mpresso/Hardware/PCB/EDU-NXP/Doc/CIAA_KIDS_Pinouts_Rev_0.0.xlsx

Sheet: CIAA_XXXX
CIAA_xxxx
CIAA_xxxx |  |  | LPC4337
On-board | I/O Expansion | expansion | Pin # | ALT0 | ALT1 | ALT2 | ALT3 | ALT4
 | P1 | TEC_F0 | 1 | DIN0
 | P1 | Entrada Analog. 0 | 2 | ADCO_1 | ADC1_1
 | P1 | TEC_F1 | 3 | DIN1
 |  |  | 4 | VSSIO
 |  |  | 5 | VDDIO
 | P1 | Salida Analog. | 6 | DAC | ADC0_0 | ADC1_0
 | P1 | TEC_F3 | 7 | DIN3
 | P1 | TEC_F2 | 8 | DIN2
 | P1 | LCD1 | 9 | DOUT
 | P1 | LCD2 | 10 | DOUT
 | P1 | LCD3 | 11 | DOUT
XTAL1 |  |  | 12 | XTAL1
XTAL2 |  |  | 13 | XTAL2
 |  |  | 14 | P4_7
 | P1 | LCD_RS | 15 | DOUT
 |  |  | 16 | USB0_VDDA_3V3_DRIVER
 |  |  | 17 | USB0_VDDA3V3
USB0 |  | USB_DP | 18 | USB0_DP
 |  |  | 19 | USB0_VSSA_TERM
USB0 |  | USB_DM | 20 | USB0_DM
USB0 |  | USB_VBUS | 21 | USB0VBUS
USB0 |  | USB_ID | 22 | USB0_ID
 |  |  | 23 | USB0_VSSA_REF
 |  |  | 24 | USB0_RREF
 |  |  | 25 | VDDREG
 |  |  | 26 | TDI
 |  |  | 27 | TCK | SWDCLK
 |  |  | 28 | DBGEN
 |  |  | 29 | nTRST
 |  |  | 30 | TMS | SWDIO
 |  |  | 31 | TDO | SWO
 | P2 | Ethernet_RXD1 | 32 | P0_0
 | P1 | LCD_EN | 33 | DOUT
 | P2 | Ether_TX_EN | 34 | P0_1
 | P1 | LCD | 35 | DOUT
 |  |  | 36 | VDDIO
 |  |  | 37 | P5_0
PULS_0 |  | DIN | 38 | P1_0
 |  |  | 39 | P5_1
VSSIO |  |  | 40 | VSSIO
VDDIO |  |  | 41 | VDDIO
PULS_1 |  | DIN | 42 | P1_1
PULS_2 |  | DIN | 43 | P1_2
 | P2 | SPI_MISO | 44 | P1_3
 |  |  | 45
 |  |  | 46 | P5_2
 | P2 | SPI_MOSI | 47 | P1_4
 | P1 | TEC_COL0 | 48 | DIN
PULS_3 |  | DIN | 49 | P1_6
 |  |  | 50 | P1_7
 |  |  | 51 | P1_8
 |  |  | 52 | P1_9
 |  |  | 53 | P1_10
 |  |  | 54 | P5_3
 |  |  | 55 | P1_11
 |  |  | 56 | P1_12
 |  |  | 57 | P5_4
 |  |  | 58 | P5_5
VDDREG |  |  | 59 | VDDREG
 |  |  | 60 | P1_13
 |  |  | 61 | P1_14
 | P2 | Ethernet_rxdo | 62 | P1_15
 |  |  | 63 | P5_6
 | P2 | Ethernet_CRS_DV | 64 | P1_16
 |  |  | 65 | P5_7
 | P2 | Ethernet_MDIO | 66 | P1_17
 | P2 | Ethernet_TXDO | 67 | P1_18
 | P2 | Ethernet_REF_CLK | 68 | P1_19
RS485 |  | RS485_TXD | 69 | P9_5
 | P2 | Ethernet_TXD1 | 70 | P1_20
VDDIO |  |  | 71 | VDDIO
RS485 |  | RS485_RXD | 72 | P9_6
 |  |  | 73 | P6_0
 | P1 | GPIO0 | 74 | P6_1
led0_r |  | DOUT | 75 | P2_0
VSSIO |  |  | 76 | VSSIO
VDDIO |  |  | 77 | VDDIO
RS485 |  | RS485_DIR | 78 | P6_2
USB0 |  | USB_PPWR | 79 | P6_3
 |  |  | 80 | P6_4
ledo_g |  | DOUT | 81 | P2_1
 |  |  | 82 | P6_5
USB0 |  | USB_PWR_FAULT | 83 | P6_6
led0_b |  | DOUT | 84 | P2_2
 |  |  | 85 | P6_7 | GPIO03 | RS232_CTS | SPI_CS
 |  |  | 86 | P6_8
 | P2 | RS232_TXD | 87 | P2_3 | RS232_TXD
 | P2 | RS232_RXD | 88 | P2_4 | RS232_RXD
USB1 |  | USB_DP | 89 | USB1_DP
USB1 |  | USB_DM | 90 | USB1_DM
 | P1 | GPIO3 | 91 | P2_5 | GPIO1 | CAN_STB
 | P2 | I2C | 92 | I2C0_SCL
 | P2 | I2C | 93 | I2C0_SDA
VDDREG |  |  | 94 | VDDREG
 | P1 | GPIO1 | 95 | P2_6
 |  |  | 96 | P2_7
 |  |  | 97 | P6_9
led1_r |  | DOUT | 98 | P2_8
 |  |  | 99
led2_r |  | DOUT | 100 | P6_10
led2_g |  | DOUT | 101 | P6_11
led1_g |  | DOUT | 102 | P2_9
led2_b |  | DOUT | 103 | P6_12
led1_b |  | DOUT | 104 | P2_10
led3_r |  | DOUT | 105 | P2_11
led3_g |  | DOUT | 106 | P2_12
 |  |  | 107 | VDDIO
led3_b |  | DOUT | 108 | P2_13
VSSIO |  |  | 109 | VSSIO
 | P1 | GPIO4 | 110 | P7_0 | GPIO2 | RS232_RTS
VDDIO |  |  | 111 | VDDIO
 |  |  | 112 | P3_0
 |  |  | 113 | P7_1
 | P2 | CAN_RD | 114 | P3_1
 |  |  | 115 | P7_2
 | P2 | CAN_TD | 116 | P3_2
 |  |  | 117 | P7_3
 |  |  | 118 | P3_3
 |  |  | 119 | P3_4
 | P2 | SPI_SCK | 120 | PF_4
 |  |  | 121 | P3_5
 |  |  | 122 | P3_6
 |  |  | 123 | P3_7
 |  |  | 124 | P3_8
RTCX1 |  |  | 125 | RTCX1
RTCX2 |  |  | 126 | RTCX2
 |  |  | 127 | VBAT
RESET | CON | RESET | 128 | nRESET
 | P2 | GPIO5 | 129 | RTC_ALARM | GPIO5 | RTC_ALARM
 | P2 | WAKEUP | 130 | WAKEUP0
 |  |  | 131 | VDDREG
 | P1 | TEC_COL1 | 132 | P7_4
 | P1 | TEC_COL2 | 133 | P7_5
 | P1 | ISP | 134
VSSA |  |  | 135 | VSSA
 | P2 | GPIO6 | 136 | GPIO | ADC0_7 | ADC1_7
VDDA |  |  | 137 | VDDA
 | COM0 | Entrada Analog. 3 | 138 | ADC0_4 | ADC1_4
 | P1 | Entrada Analog. 2 | 139 | ADC0_3 | ADC1_3
 | P2 | Ethernet_MDC | 140 | P7_7
VDDIO |  |  | 141 | VDDIO
 | P2 | GPIO7 | 142 | GPIO | ADC0_6 | ADC1_6
 | P1 | Entrada Analog. 1 | 143 | ADC0_2 | adc1_2
 | P2 | GPIO8 | 144 | GPIO | ADC0_5 | ADC1_5

Sheet: EXPANSION
COM0 |  |  |  | COM1
Pin | Señal | Pin | Señal | Pin | Señal | Pin | Señal
1 | TEC_F0 | 2 | ADC0_1 | 1 | ETH_MDC | 2 | SPI_SCK
3 | TEC_F1 | 4 | ADC0_2 | 3 | ETH_RXD1 | 4 | SPI_MISO
5 | TEC_F2 | 6 | GND | 5 | ETH_TX_EN | 6 | SPI_MOSI
7 | TEC_F3 | 8 | ADC0_3 | 7 | ETH_RXD0 | 8 | GND
9 | TEC_COL0 | 10 | ADC0_4 | 9 | RTH_CRS_DV | 10 | I2C_SCL
11 | TEC_COL1 | 12 | GND | 11 | ETH_MDIO | 12 | I2C_SDA
13 | TEC_COL2 | 14 | GPIO0 | 13 | ETH_TCD0 | 14 | GND
15 | TEC_ISP | 16 | GPIO1 | 15 | ETH_REF_CLK | 16 | CAN_RD
17 | GND | 18 | GPIO2 | 17 | ETH_TXDI | 18 | CAN_TD
19 | RESET | 20 | GPIO3 | 19 | GND | 20 | GND
21 | WAKEUP | 22 | GPIO4 | 21 | GND | 22 | GPIO5
23 | GND | 24 | GND | 23 | RESET | 24 | GPIO6
25 | VDDIO | 26 | VDDA | 25 | VDDIO | 26 | VDDA
27 | VSSA | 28 |  | 27 | VSSA | 28
