mpresso/Hardware/PCB/EDU-NXP/docs/LPC4330_Xplorer_schematic.pdf

# Page 2

# Power,Flash,SDcard

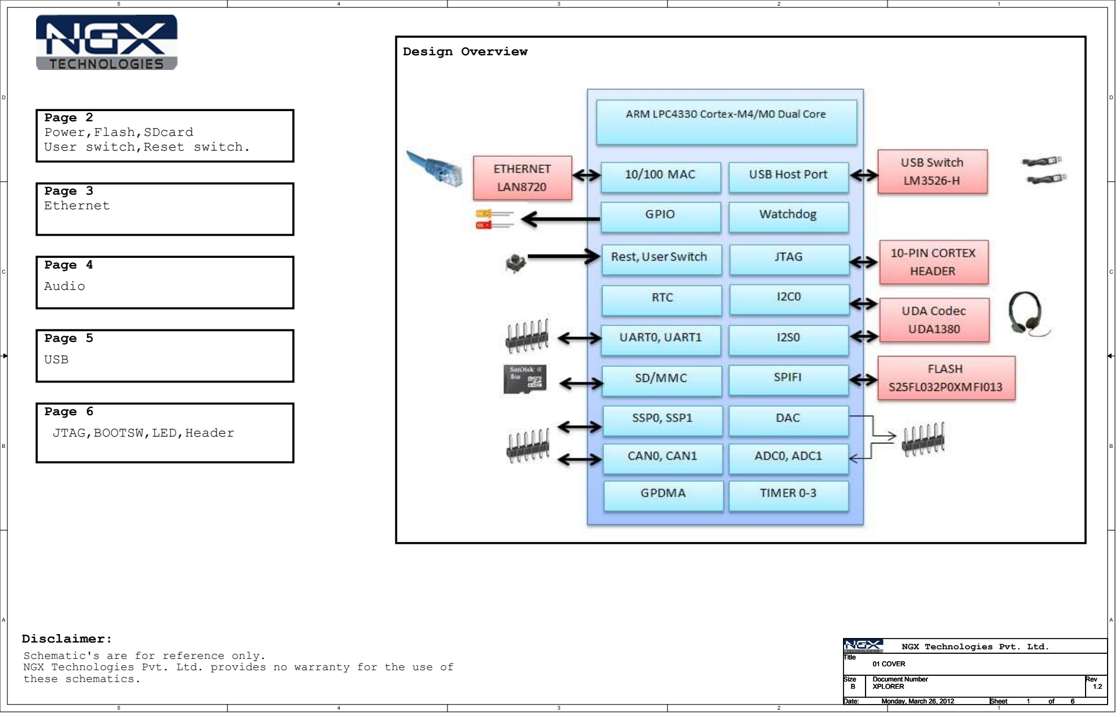
[picture p2: page 1]
Page 3; Page 4; Ethernet; Page 5; USB; Design Overview; Audio; Title; Size; Document Number; Rev; Date:; Sheet; XPLORER; 01 COVER; Monday, March 26, 2012

User switch,Reset switch.

Page 6
JTAG,BOOTSW,LED,Header

Disclaimer:
Schematic's are for reference only.
NGX Technologies Pvt. Ltd. provides no warranty for the use of
these schematics.

NGX Technologies Pvt. Ltd.

RESET SWITCH | USER SWITCH

# SD CARD

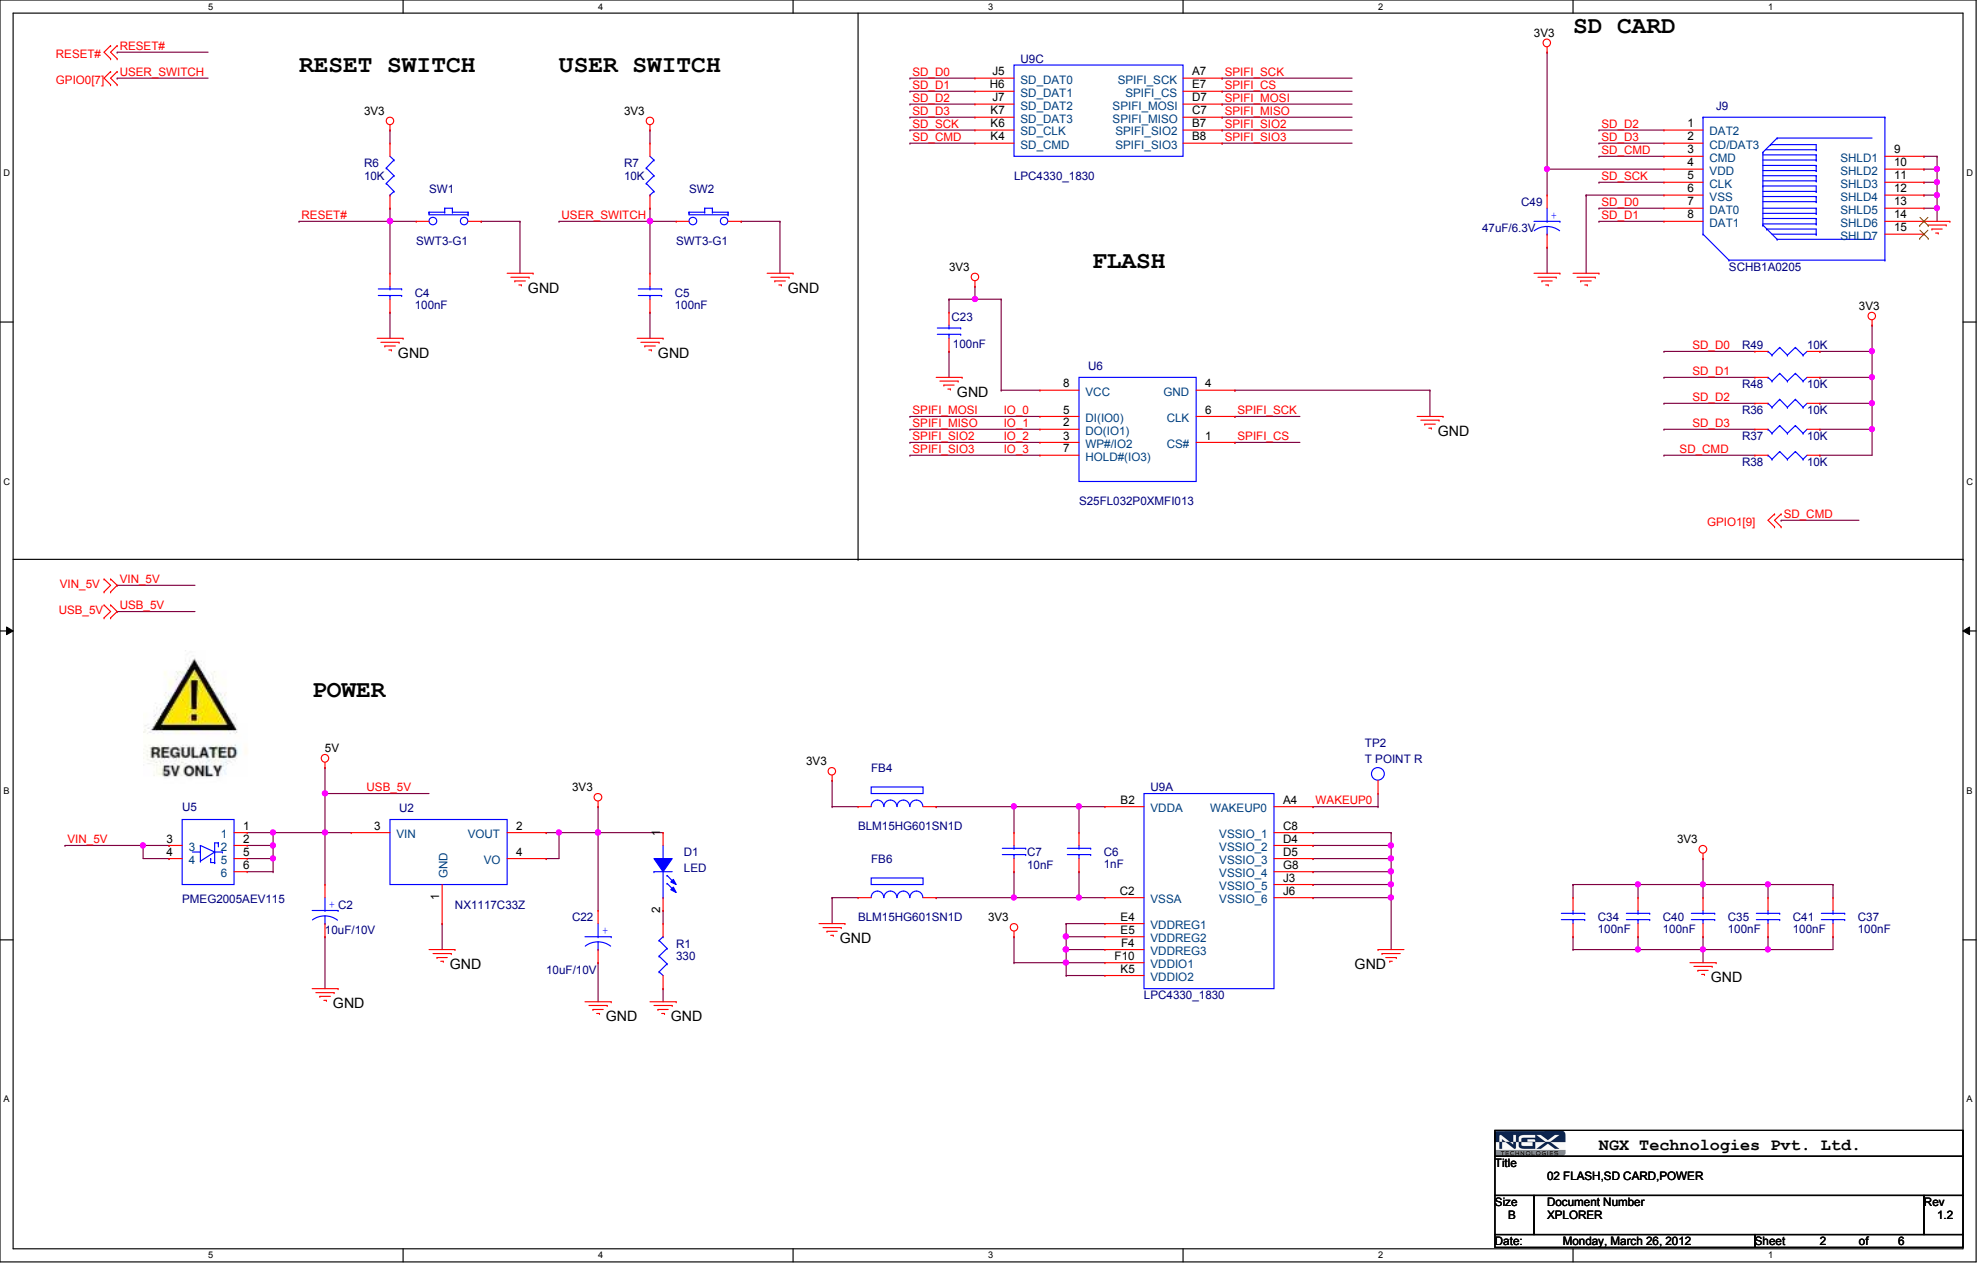
[picture p3: page 2]

NGX Technologies Pvt. Ltd.

02 FLASH,SD CARD,POWER

# ETHERNET

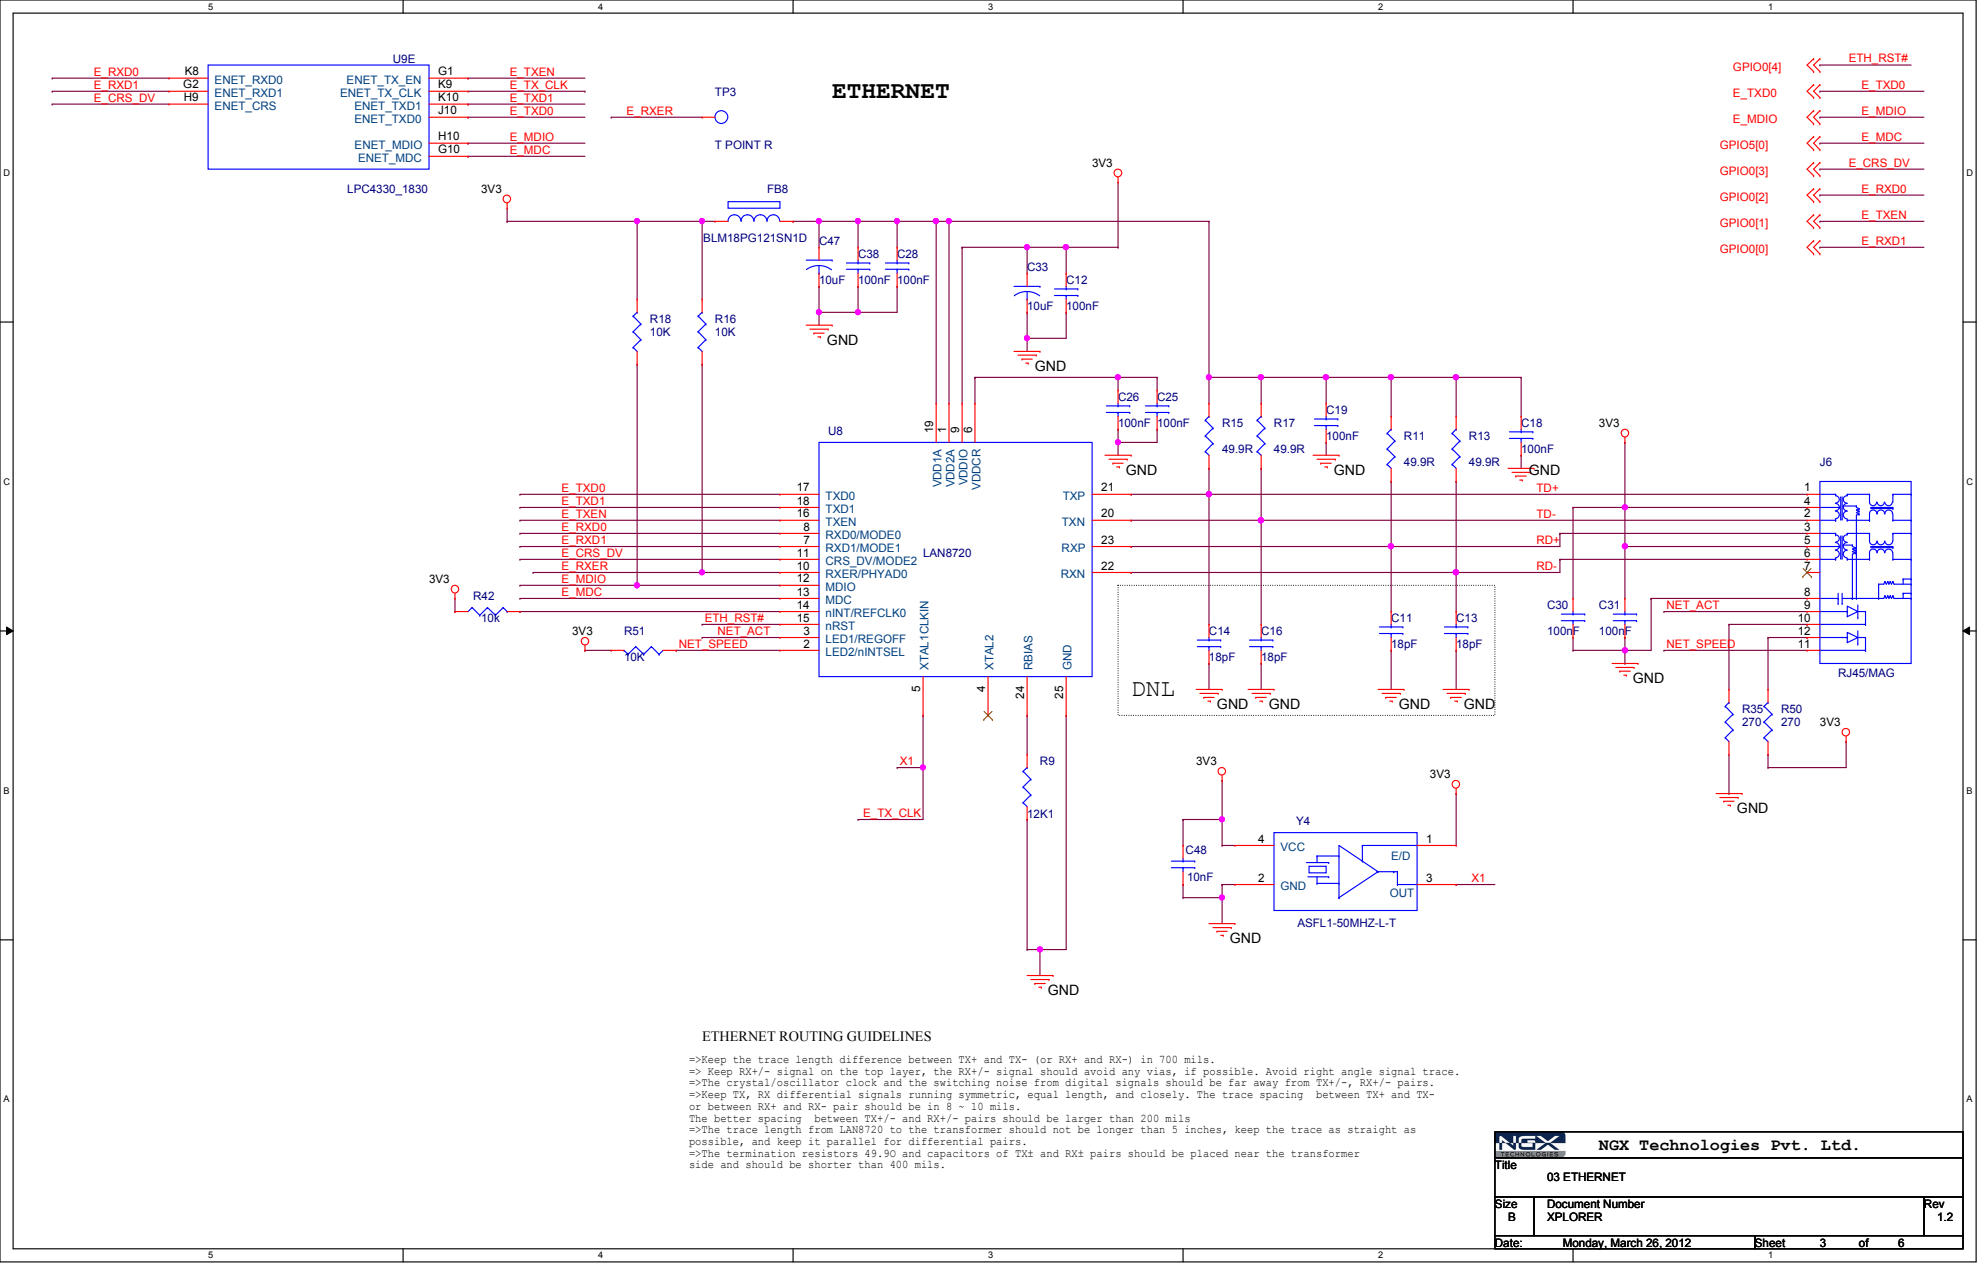
[picture p4: page 3]

=>Keep the trace length difference between TX+ and TX- (or RX+ and RX-) in 700 mils.
=> Keep RX+/- signal on the top layer, the RX+/- signal should avoid any vias, if possible. Avoid right angle signal trace.
=>The crystal/oscillator clock and the switching noise from digital signals should be far away from TX+/-, RX+/- pairs.
=>Keep TX, RX differential signals running symmetric, equal length, and closely. The trace spacing between TX+ and TX-
or between RX+ and RX- pair should be in 8 ~ 10 mils.
The better spacing between TX+/- and RX+/- pairs should be larger than 200 mils
=>The trace length from LAN8720 to the transformer should not be longer than 5 inches, keep the trace as straight as
possible, and keep it parallel for differential pairs.
=>The termination resistors 49.9O and capacitors of TX± and RX± pairs should be placed near the transformer
side and should be shorter than 400 mils.

NGX Technologies Pvt. Ltd.

# UDA CODEC

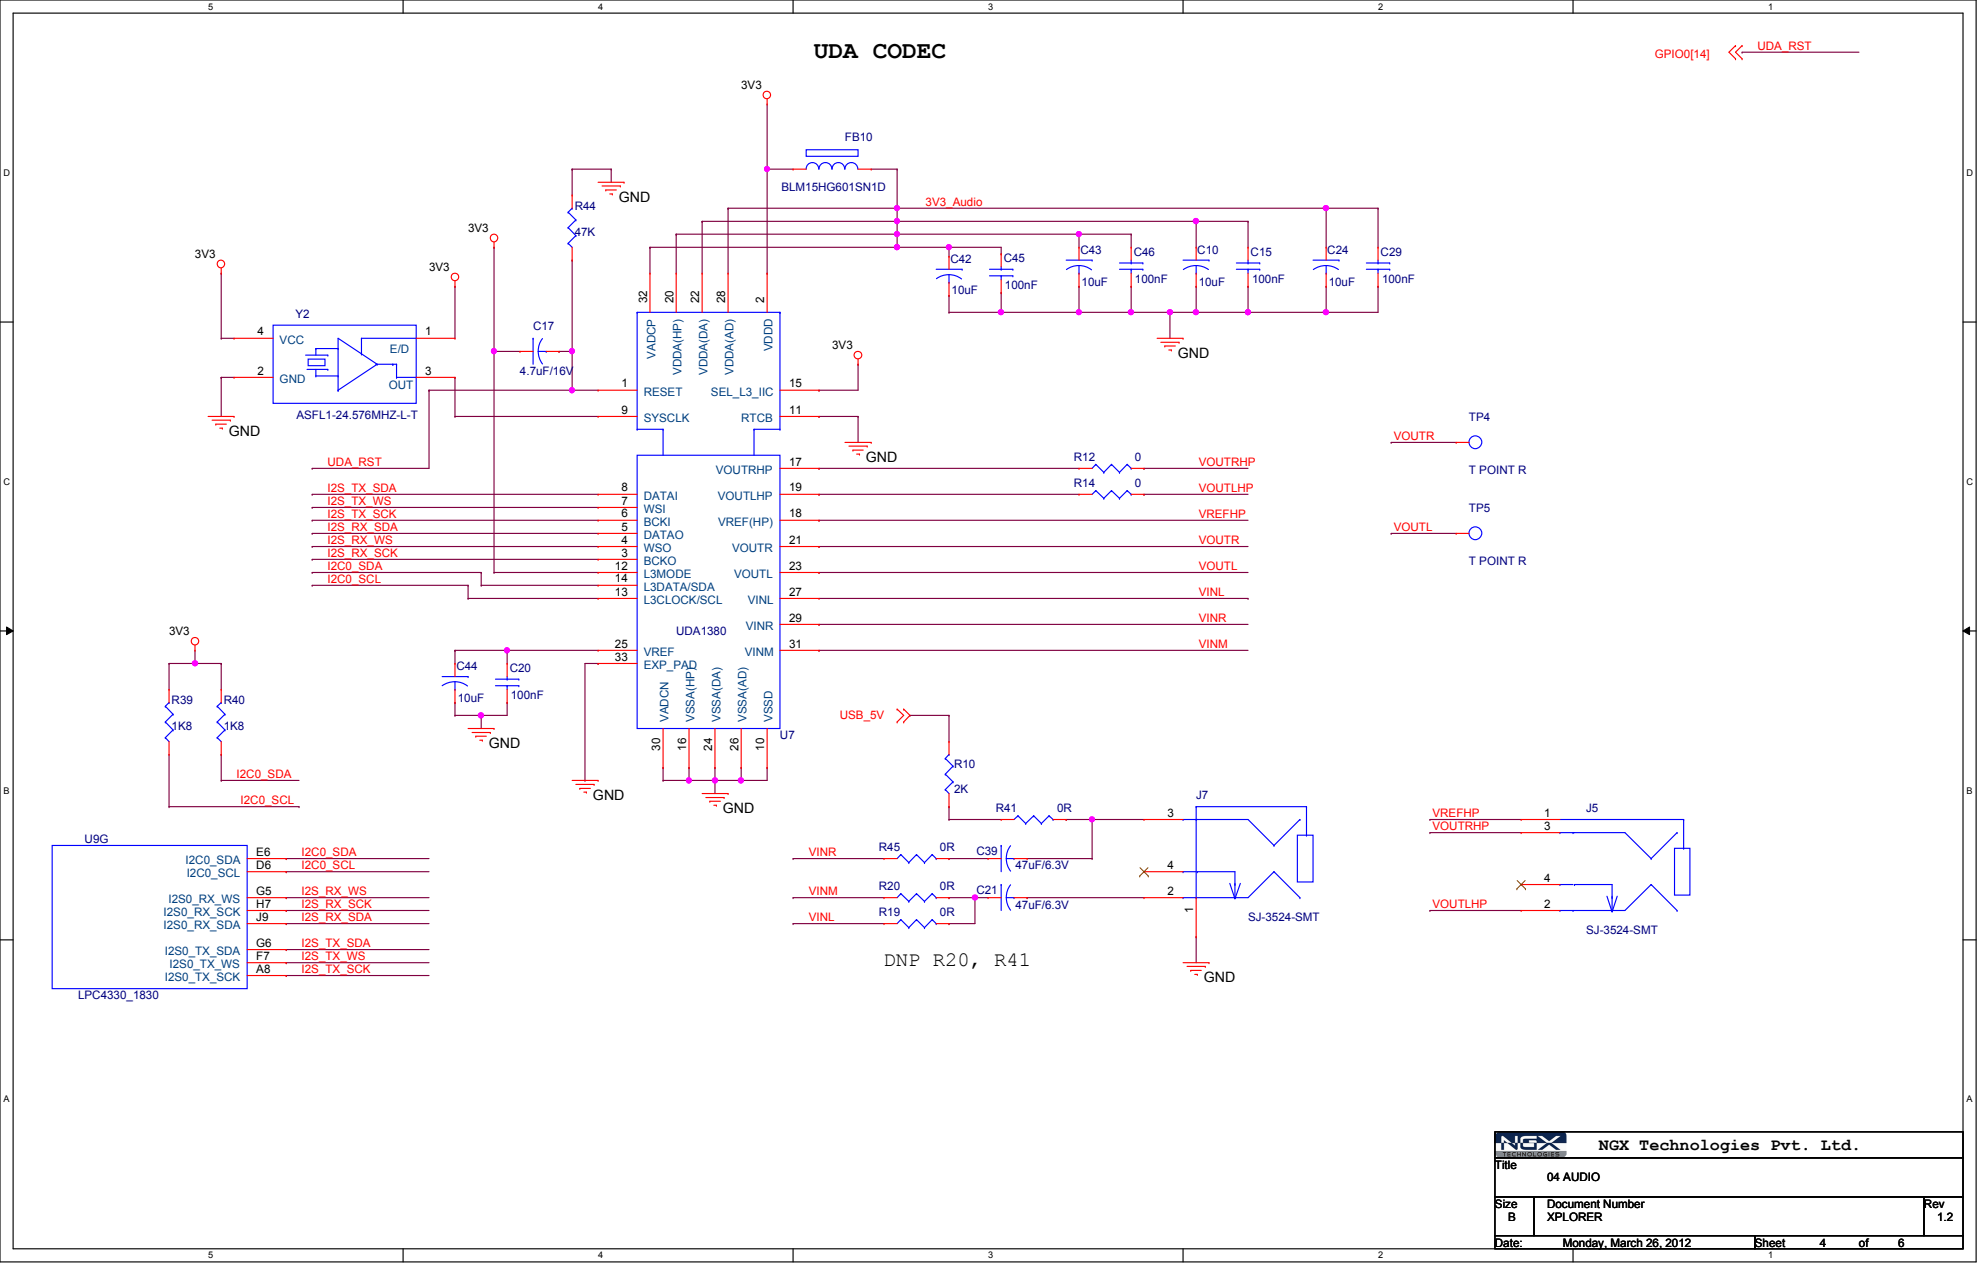
[picture p5: page 4]

NGX Technologies Pvt. Ltd.

# USB SECTION

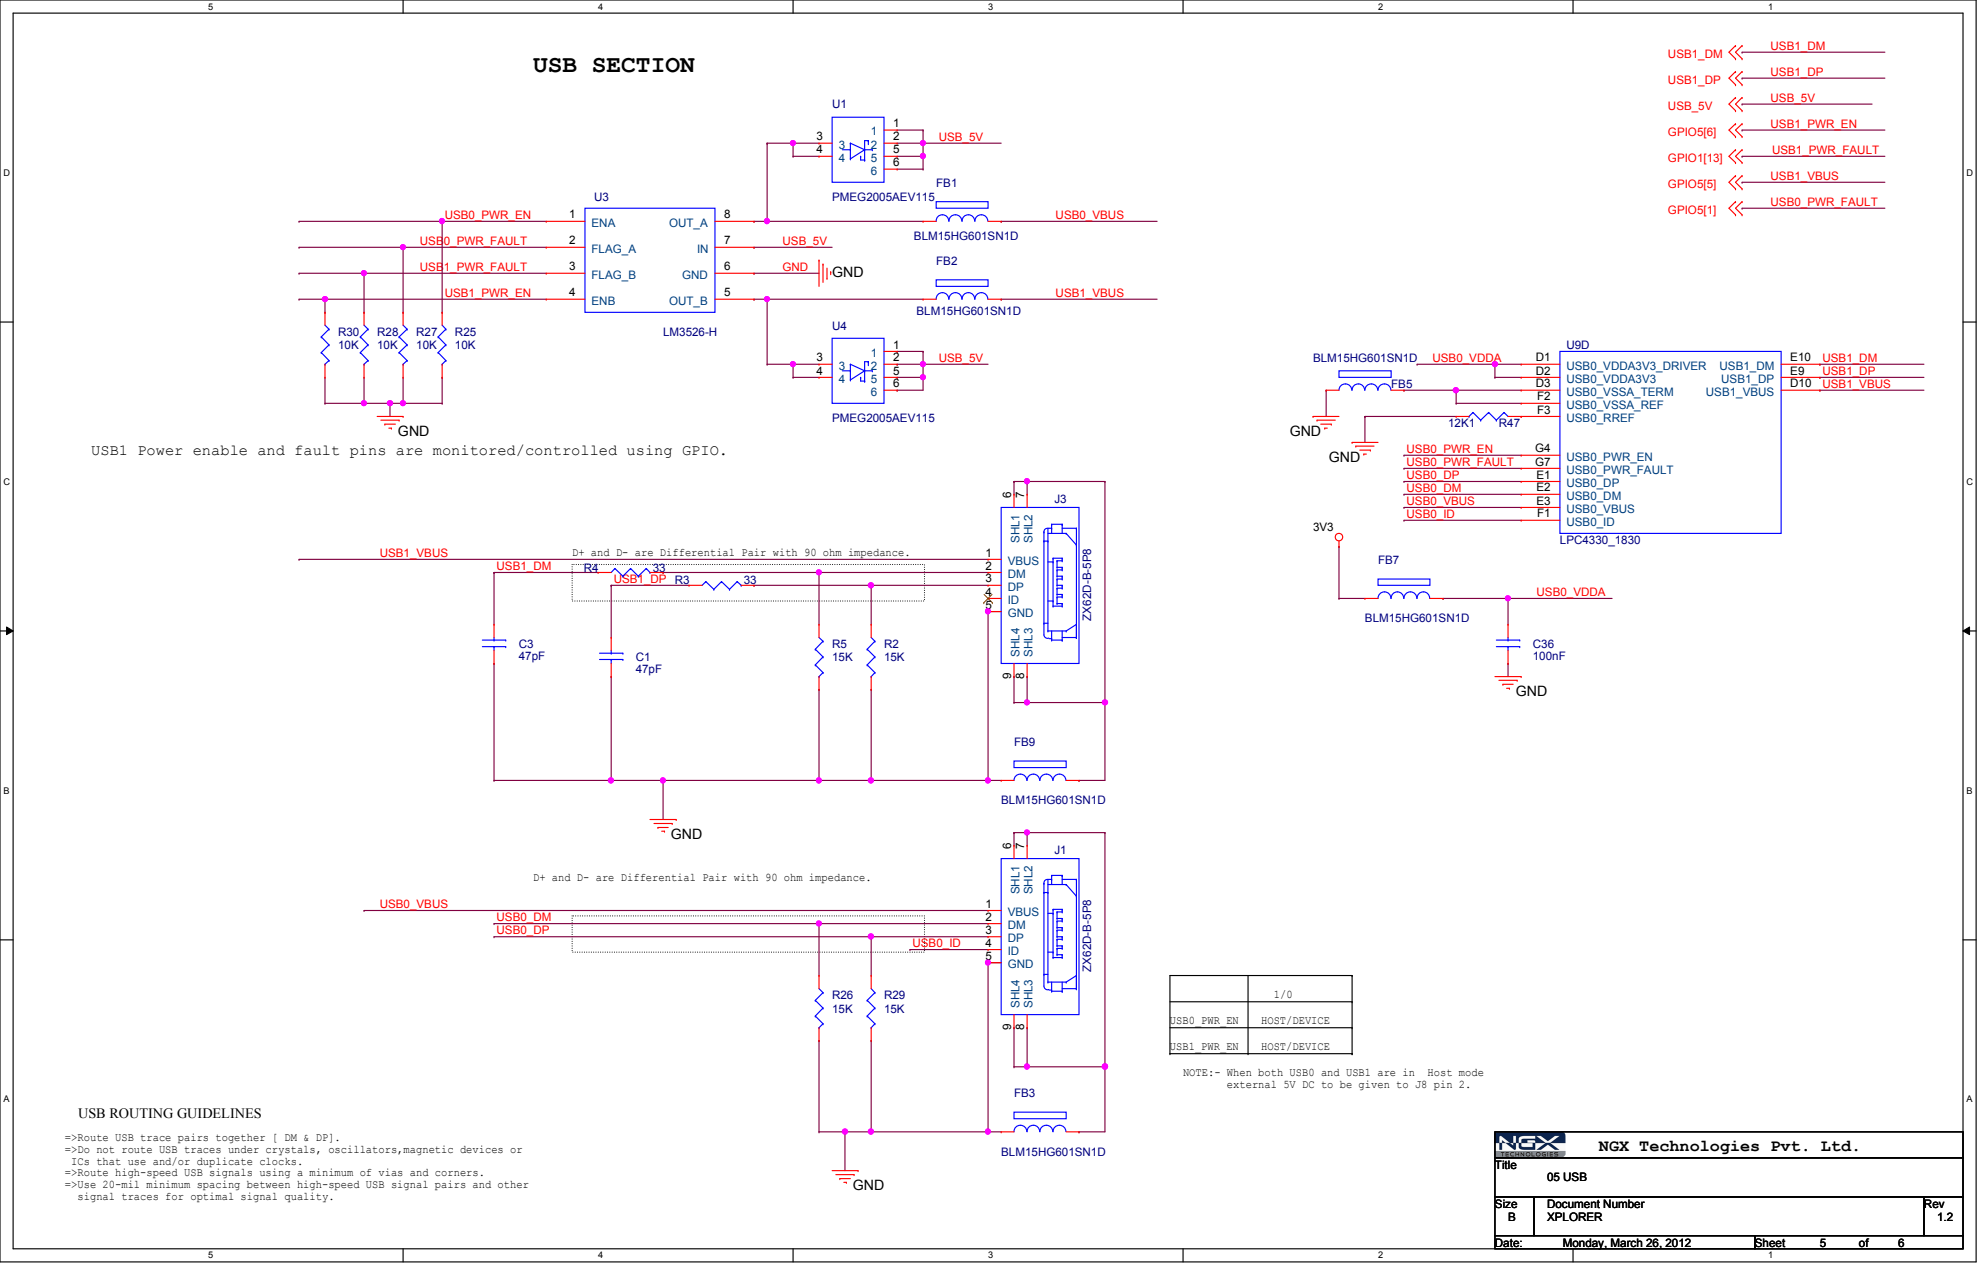
[picture p6: page 5]

USB1 Power enable and fault pins are monitored/controlled using GPIO.

D+ and D- are Differential Pair with 90 ohm impedance.
USB1_DP

ZX62D-B-5P8 VBUS 1 DM 2 DP 3 ID 4 GND 5

USB0_PWR_EN | HOST/DEVICE

USB1_PWR_EN | HOST/DEVICE

NOTE:- When both USB0 and USB1 are in Host mode

external 5V DC to be given to J8 pin 2.

=>Route USB trace pairs together [ DM & DP].
=>Do not route USB traces under crystals, oscillators,magnetic devices or
ICs that use and/or duplicate clocks.
=>Route high-speed USB signals using a minimum of vias and corners.
=>Use 20-mil minimum spacing between high-speed USB signal pairs and other
signal traces for optimal signal quality.

NGX Technologies Pvt. Ltd.

# BOOT SELECT SWITCH

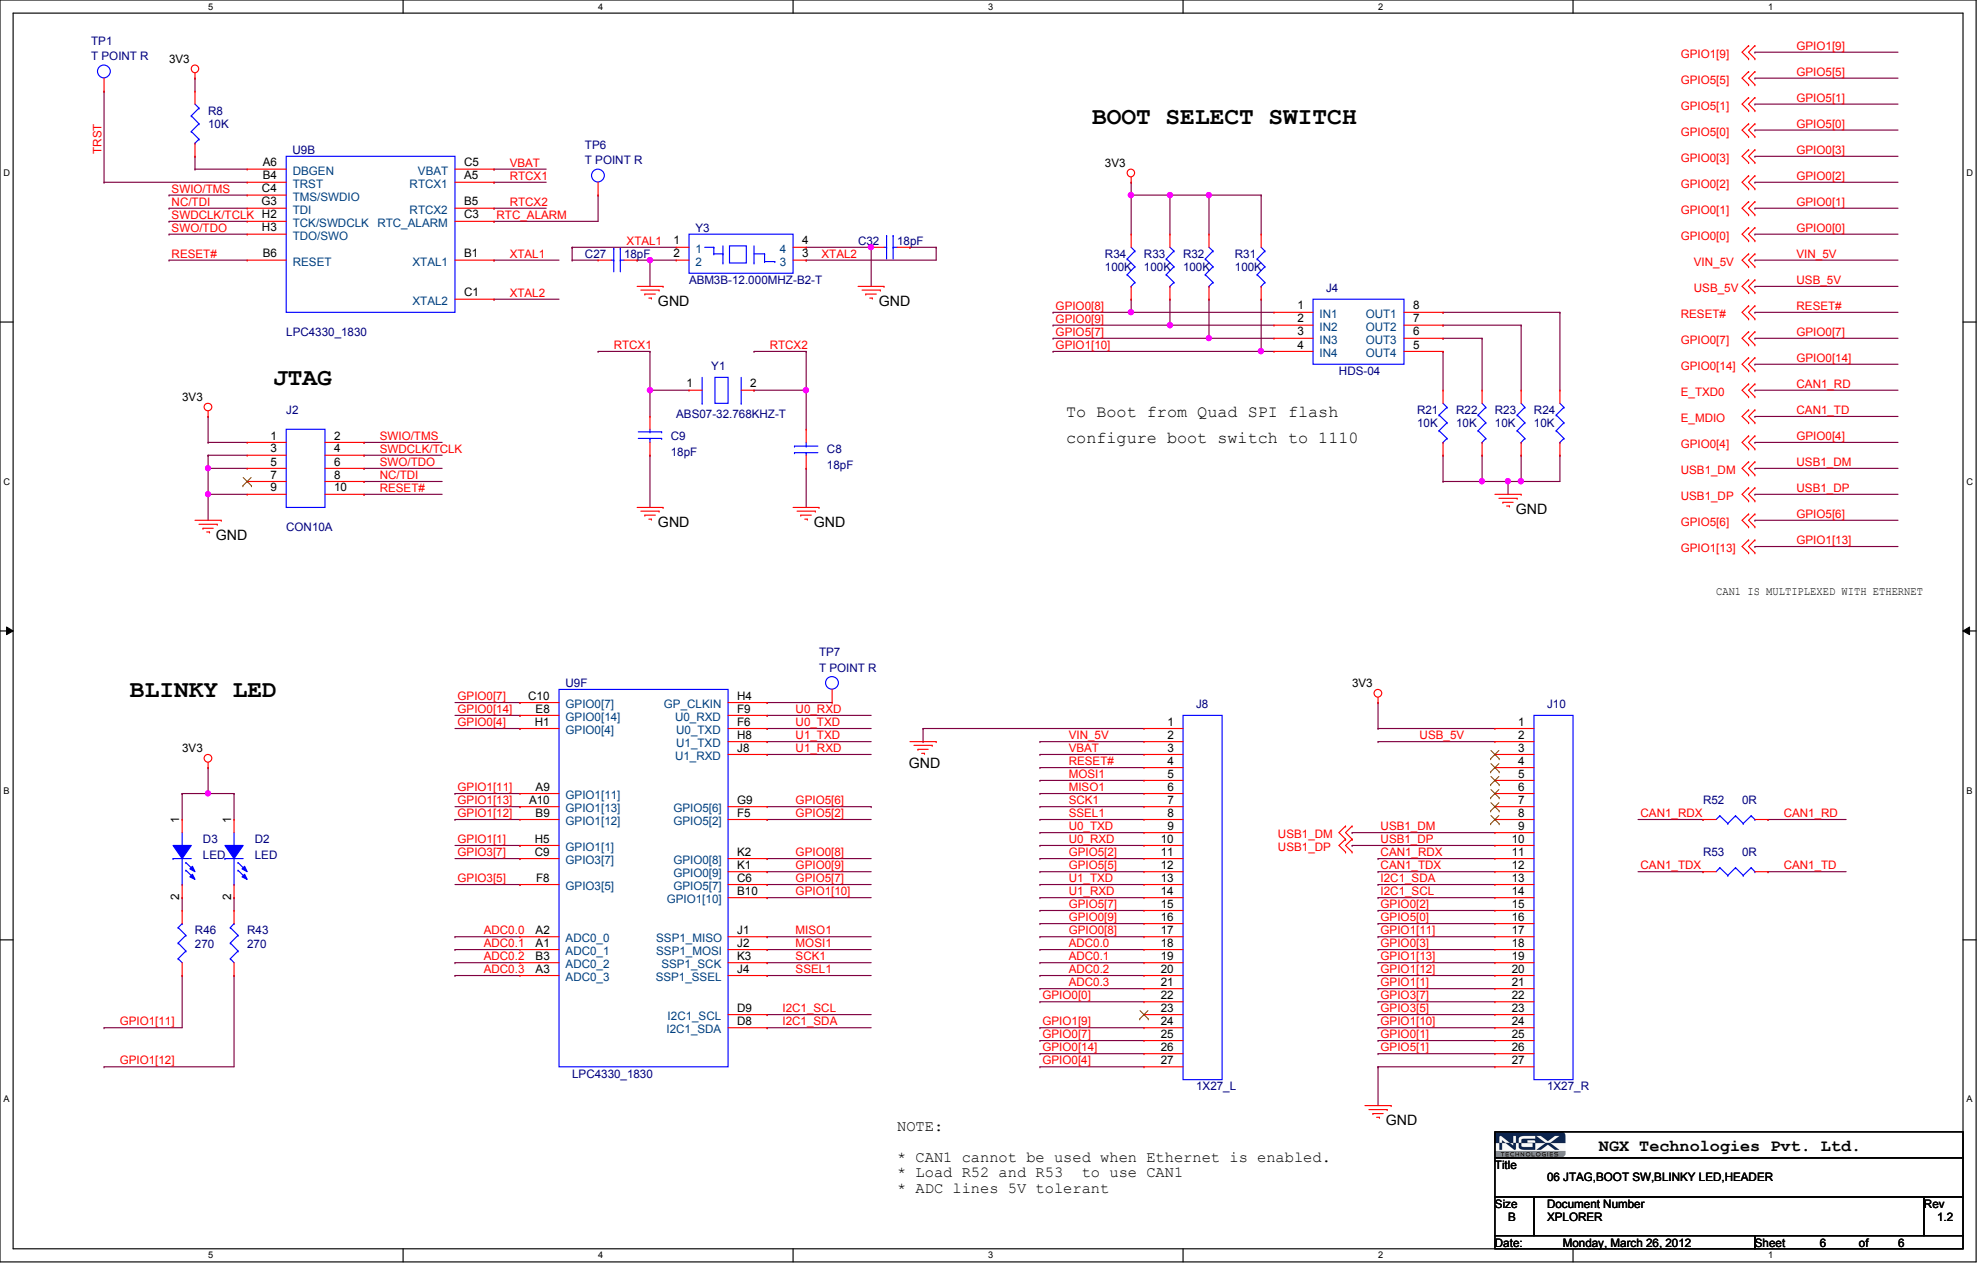
[picture p7: page 6]

To Boot from Quad SPI flash
configure boot switch to 1110

CAN1 IS MULTIPLEXED WITH ETHERNET

NGX Technologies Pvt. Ltd.

* CAN1 cannot be used when Ethernet is enabled.
* ADC lines 5V tolerant

06 JTAG,BOOT SW,BLINKY LED,HEADER
