mpresso/Hardware/PCB/EDU-NXP/edu-ciaa-nxp.kicad_pcb

## KiCad design PCB/EDU-NXP/edu-ciaa-nxp.kicad_pcb (2014-07-04)

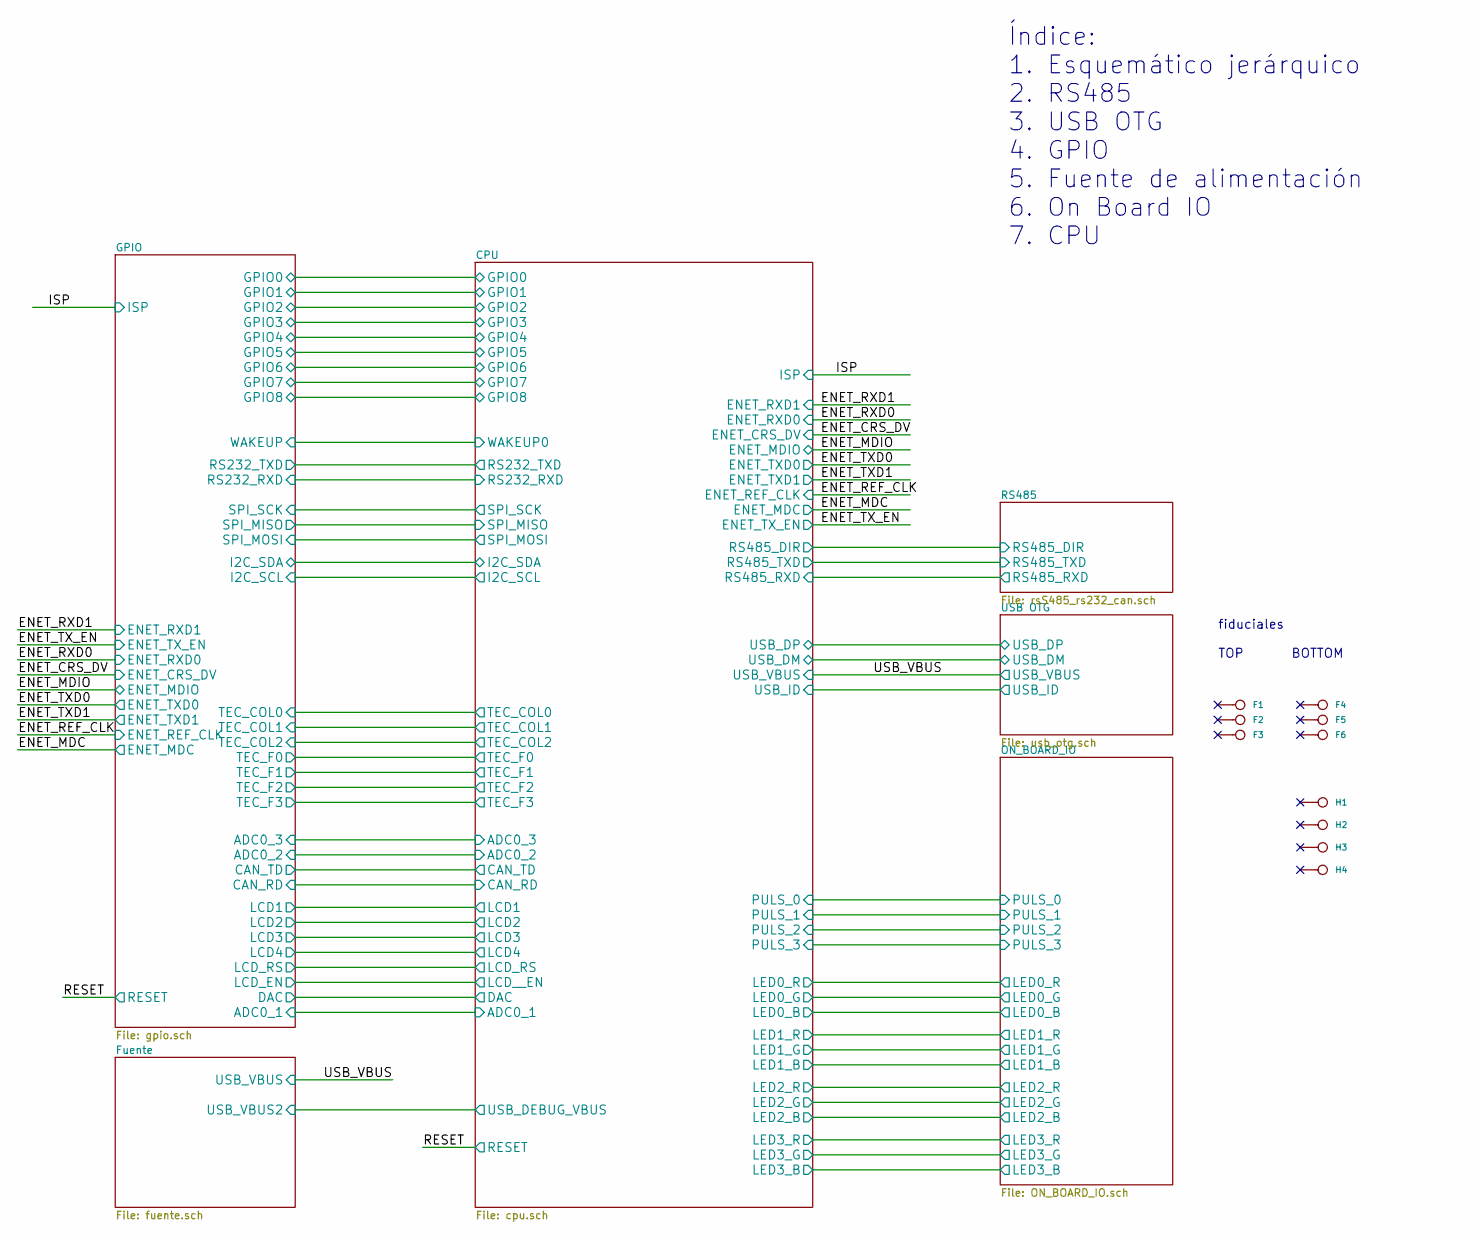
[picture p8: schematic edu-ciaa-nxp.sch, EDU CIAA NXP]

Parts:
F1, F2, F3, F4, F5, F6: fiducial
H1, H2, H3, H4: 4mm

Notes on the sheet:
Índice: 1. Esquemático jerárquico 2. RS485 3. USB OTG 4. GPIO 5. Fuente de alimentación 6. On Board IO 7. CPU
fiduciales TOP BOTTOM

Schematic: rsS485_rs232_can.sch, EDU CIAA RS485

Parts:
C1: 10uF / 6V3
C2: 100nF
D1, D2, D3: PSD12C
J1: TB_1X3
JP1, JP2, JP3, JP4: JUMPER-2
PS1, PS2: USMF020
R1, R2, R3: 4K7
R4, R5: 100K
R6, R8: 680
R7: 120
R9: 100 / 1/2W
U1: MAX3072; SOIC8

Connections:
+5V: C1.2, C2.1 (A), D1.1 (cathode), R4.1 (A), R6.1 (A), U1.8 (VCC); also elsewhere on the board
/CPU/RS485_DIR: JP1.1, R3.1 (A), U1.3 (DE); also elsewhere on the board
/CPU/RS485_RXD: R1.2 (B), U1.1 (RO); also elsewhere on the board
/CPU/RS485_TXD: U1.4 (DI); also elsewhere on the board
GND: C1.1 (GND), C2.2 (B), D3.2 (Anode), R2.2 (B), R3.2 (B), R5.2 (B), R8.2 (B), R9.1 (A), U1.5 (GND); also elsewhere on the board
unnamed 144: J1.2, PS2.2; also elsewhere on the board
unnamed 145: J1.3, R9.2 (B); also elsewhere on the board
unnamed 146: J1.1, PS1.2; also elsewhere on the board
unnamed: D1.2 (Anode), D2.1 (cathode), JP2.1, JP3.2, PS1.1, R4.2 (B), U1.6 (A)
unnamed: JP4.1, R8.1 (A)
unnamed: JP2.2, R6.2 (B)
unnamed: JP3.1, R7.1 (A)
unnamed: JP1.2, R2.1 (A), U1.2 (~RE~)
unnamed: D2.2 (Anode), D3.1 (cathode), JP4.2, PS2.1, R5.1 (A), R7.2 (B), U1.7 (B)

Notes on the sheet:
RS485
JP1, JP2, JP4: cortocircuitar en caso que sea el último nodo de la red.
De acuerdo a Fig 27 de la AN: slla070d de TI.

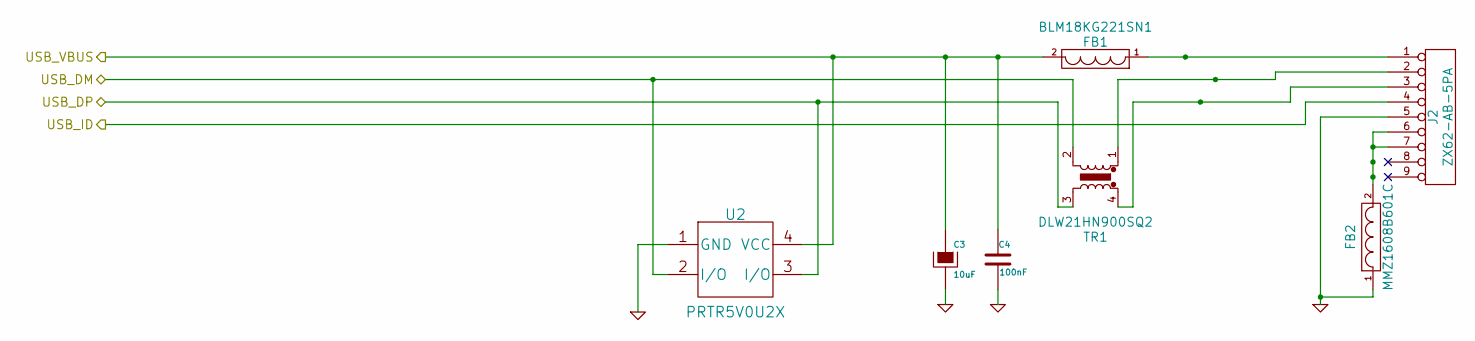
[picture p9: schematic usb_otg.sch, EDU CIAA USB OTG]

Parts:
C3: 10uF
C4: 100nF
FB1: BLM18KG221SN1
FB2: MMZ1608B601C
J2: ZX62-AB-5PA
TR1: DLW21HN900SQ2
U2: PRTR5V0U2X

Connections:
/CPU/USB_DM: TR1.2, U2.2 (I/O); also elsewhere on the board
/CPU/USB_DP: TR1.3, U2.3 (I/O); also elsewhere on the board
/CPU/USB_ID: J2.4; also elsewhere on the board
/CPU/USB_VBUS: C3.1, C4.1, FB1.2, U2.4 (VCC); also elsewhere on the board
GND: C3.2, C4.2, FB2.1, J2.5, U2.1 (GND); also elsewhere on the board
unnamed: FB2.2, J2.6, J2.7
unnamed: J2.3, TR1.4
unnamed: FB1.1, J2.1
unnamed: J2.2, TR1.1

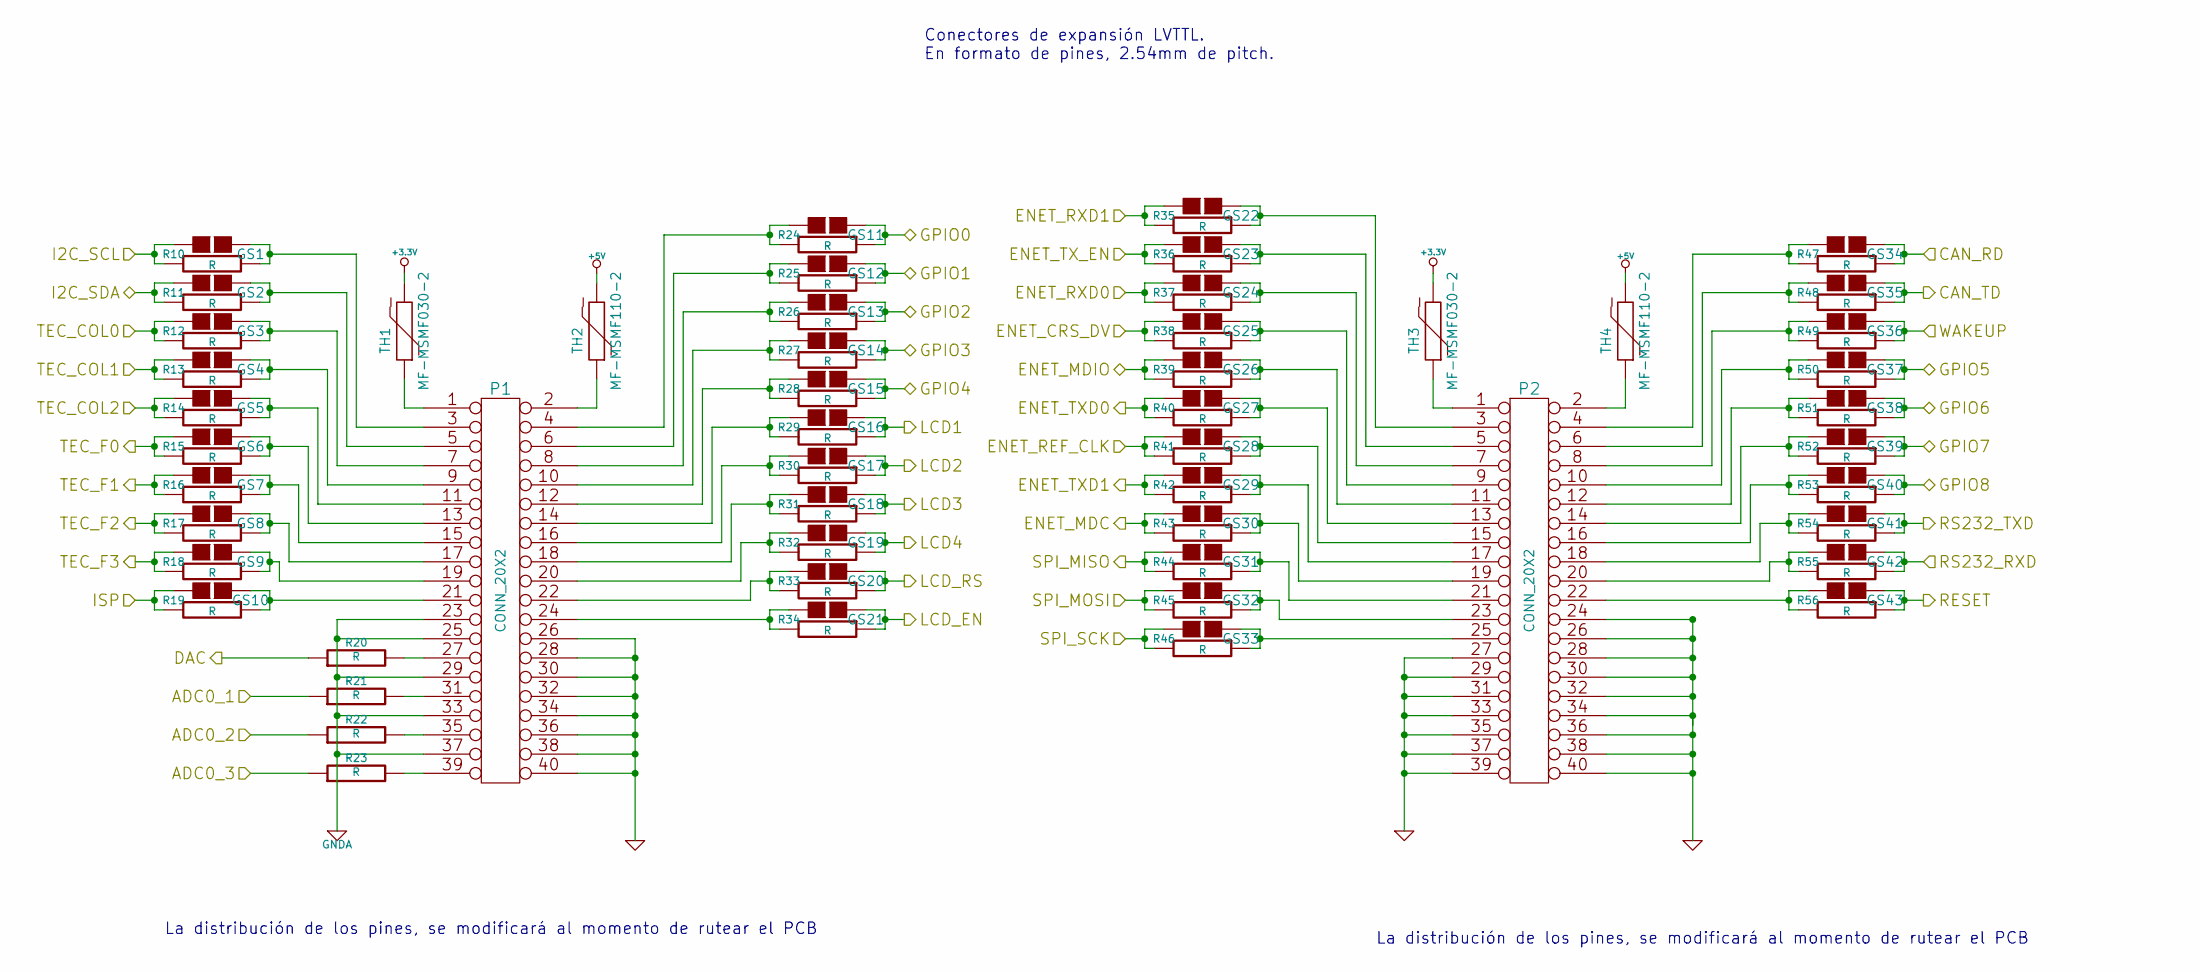
[picture p10: schematic gpio.sch, EDU CIAA GPIO]

Parts:
GS1, GS2, GS3, GS4, GS5, GS6, GS7, GS8, GS9, GS10, GS11, GS12, GS13, GS14, GS15, GS16, GS17, GS18, GS19, GS20, GS21, GS22, GS23, GS24, GS25, GS26, GS27, GS28, GS29, GS30, GS31, GS32, GS33, GS34, GS35, GS36, GS37, GS38, GS39, GS40, GS41, GS42, GS43: GS2
P1, P2: CONN_20X2
R10, R11, R12, R13, R14, R15, R16, R17, R18, R19, R20, R21, R22, R23, R24, R25, R26, R27, R28, R29, R30, R31, R32, R33, R34, R35, R36, R37, R38, R39, R40, R41, R42, R43, R44, R45, R46, R47, R48, R49, R50, R51, R52, R53, R54, R55, R56: R
TH1, TH3: MF-MSMF030-2
TH2, TH4: MF-MSMF110-2

Connections:
+5V: TH2.2, TH4.2; also elsewhere on the board
/CPU/ADC0_1: R21.1; also elsewhere on the board
/CPU/ADC0_2: R22.1; also elsewhere on the board
/CPU/ADC0_3: R23.1; also elsewhere on the board
/CPU/CAN_RD: GS34.2 (G2), R47.1; also elsewhere on the board
/CPU/CAN_TD: GS35.2 (G2), R48.1; also elsewhere on the board
/CPU/DAC: R20.1; also elsewhere on the board
/CPU/ENET_CRS_DV: GS25.1 (G1), R38.2; also elsewhere on the board
/CPU/ENET_MDC: GS30.1 (G1), R43.2; also elsewhere on the board
/CPU/ENET_MDIO: GS26.1 (G1), R39.2; also elsewhere on the board
/CPU/ENET_REF_CLK: GS28.1 (G1), R41.2; also elsewhere on the board
/CPU/ENET_RXD0: GS24.1 (G1), R37.2; also elsewhere on the board
/CPU/ENET_RXD1: GS22.1 (G1), R35.2; also elsewhere on the board
/CPU/ENET_TXD0: GS27.1 (G1), R40.2; also elsewhere on the board
/CPU/ENET_TXD1: GS29.1 (G1), R42.2; also elsewhere on the board
/CPU/ENET_TX_EN: GS23.1 (G1), R36.2; also elsewhere on the board
/CPU/GPIO0: GS11.2 (G2), R24.1; also elsewhere on the board
/CPU/GPIO1: GS12.2 (G2), R25.1; also elsewhere on the board
/CPU/GPIO2: GS13.2 (G2), R26.1; also elsewhere on the board
/CPU/GPIO3: GS14.2 (G2), R27.1; also elsewhere on the board
/CPU/GPIO4: GS15.2 (G2), R28.1; also elsewhere on the board
/CPU/GPIO5: GS37.2 (G2), R50.1; also elsewhere on the board
/CPU/GPIO6: GS38.2 (G2), R51.1; also elsewhere on the board
/CPU/GPIO7: GS39.2 (G2), R52.1; also elsewhere on the board
/CPU/GPIO8: GS40.2 (G2), R53.1; also elsewhere on the board
/CPU/I2C_SCL: GS1.1 (G1), R10.2; also elsewhere on the board
/CPU/I2C_SDA: GS2.1 (G1), R11.2; also elsewhere on the board
/CPU/ISP: GS10.1 (G1), R19.2; also elsewhere on the board
/CPU/LCD1: GS16.2 (G2), R29.1; also elsewhere on the board
/CPU/LCD2: GS17.2 (G2), R30.1; also elsewhere on the board
/CPU/LCD3: GS18.2 (G2), R31.1; also elsewhere on the board
/CPU/LCD4: GS19.2 (G2), R32.1; also elsewhere on the board
/CPU/LCD_RS: GS20.2 (G2), R33.1; also elsewhere on the board
/CPU/RESET: GS43.2 (G2), R56.1; also elsewhere on the board
/CPU/RS232_RXD: GS42.2 (G2), R55.1; also elsewhere on the board
/CPU/RS232_TXD: GS41.2 (G2), R54.1; also elsewhere on the board
/CPU/SPI_MISO: GS31.1 (G1), R44.2; also elsewhere on the board
/CPU/SPI_MOSI: GS32.1 (G1), R45.2; also elsewhere on the board
/CPU/SPI_SCK: GS33.1 (G1), R46.2; also elsewhere on the board
/CPU/TEC_COL0: GS3.1 (G1), R12.2; also elsewhere on the board
/CPU/TEC_COL1: GS4.1 (G1), R13.2; also elsewhere on the board
/CPU/TEC_COL2: GS5.1 (G1), R14.2; also elsewhere on the board
/CPU/TEC_F0: GS6.1 (G1), R15.2; also elsewhere on the board
/CPU/TEC_F1: GS7.1 (G1), R16.2; also elsewhere on the board
/CPU/TEC_F2: GS8.1 (G1), R17.2; also elsewhere on the board
/CPU/TEC_F3: GS9.1 (G1), R18.2; also elsewhere on the board
/GPIO/LCD_EN: GS21.2 (G2), R34.1; also elsewhere on the board
/GPIO/WAKEUP: GS36.2 (G2), R49.1; also elsewhere on the board
GND: P1.26, P1.28, P1.30, P1.32, P1.34, P1.36, P1.38, P1.40, P2.24, P2.26, P2.27, P2.28, P2.29, P2.30, P2.31, P2.32, P2.33, P2.34, P2.35, P2.36, P2.37, P2.38, P2.39, P2.40; also elsewhere on the board
GNDA: P1.23, P1.25, P1.29, P1.33, P1.37; also elsewhere on the board
unnamed: P1.2, TH2.1
unnamed: P2.1, TH3.1
unnamed: P2.2, TH4.1
unnamed: GS26.2 (G2), P2.11, R39.1
unnamed: GS25.2 (G2), P2.9, R38.1
unnamed: GS15.1 (G1), P1.12, R28.2
unnamed: GS43.1 (G1), P2.22, R56.2
unnamed: GS42.1 (G1), P2.20, R55.2
unnamed: GS41.1 (G1), P2.18, R54.2
unnamed: GS27.2 (G2), P2.13, R40.1
unnamed: GS31.2 (G2), P2.21, R44.1
unnamed: GS9.2 (G2), P1.19, R18.1
unnamed: GS18.1 (G1), P1.18, R31.2
unnamed: GS22.2 (G2), P2.3, R35.1
unnamed: GS7.2 (G2), P1.15, R16.1
unnamed: GS21.1 (G1), P1.24, R34.2
unnamed: GS16.1 (G1), P1.14, R29.2
unnamed: GS20.1 (G1), P1.22, R33.2
unnamed: GS10.2 (G2), P1.21, R19.1
unnamed: GS29.2 (G2), P2.17, R42.1
unnamed: GS40.1 (G1), P2.16, R53.2
unnamed: GS33.2 (G2), P2.25, R46.1
unnamed: GS28.2 (G2), P2.15, R41.1
unnamed: GS39.1 (G1), P2.14, R52.2
unnamed: GS32.2 (G2), P2.23, R45.1
unnamed: GS19.1 (G1), P1.20, R32.2
unnamed: GS38.1 (G1), P2.12, R51.2
unnamed: GS37.1 (G1), P2.10, R50.2
unnamed: GS24.2 (G2), P2.7, R37.1
unnamed: GS23.2 (G2), P2.5, R36.1
unnamed: P1.1, TH1.1
unnamed: GS14.1 (G1), P1.10, R27.2
unnamed: GS12.1 (G1), P1.6, R25.2
unnamed: GS2.2 (G2), P1.5, R11.1
unnamed: GS11.1 (G1), P1.4, R24.2
unnamed: P1.39, R23.2
unnamed: P1.35, R22.2
unnamed: P1.31, R21.2
unnamed: P1.27, R20.2
unnamed: GS30.2 (G2), P2.19, R43.1
unnamed: GS8.2 (G2), P1.17, R17.1
unnamed: GS17.1 (G1), P1.16, R30.2
unnamed: GS1.2 (G2), P1.3, R10.1
unnamed: GS3.2 (G2), P1.7, R12.1
unnamed: GS4.2 (G2), P1.9, R13.1
unnamed: GS13.1 (G1), P1.8, R26.2
unnamed: GS5.2 (G2), P1.11, R14.1
unnamed: GS6.2 (G2), P1.13, R15.1
unnamed: GS35.1 (G1), P2.6, R48.2
unnamed: GS34.1 (G1), P2.4, R47.2
unnamed: GS36.1 (G1), P2.8, R49.2

Notes on the sheet:
Conectores de expansión LVTTL. En formato de pines, 2.54mm de pitch.
La distribución de los pines, se modificará al momento de rutear el PCB

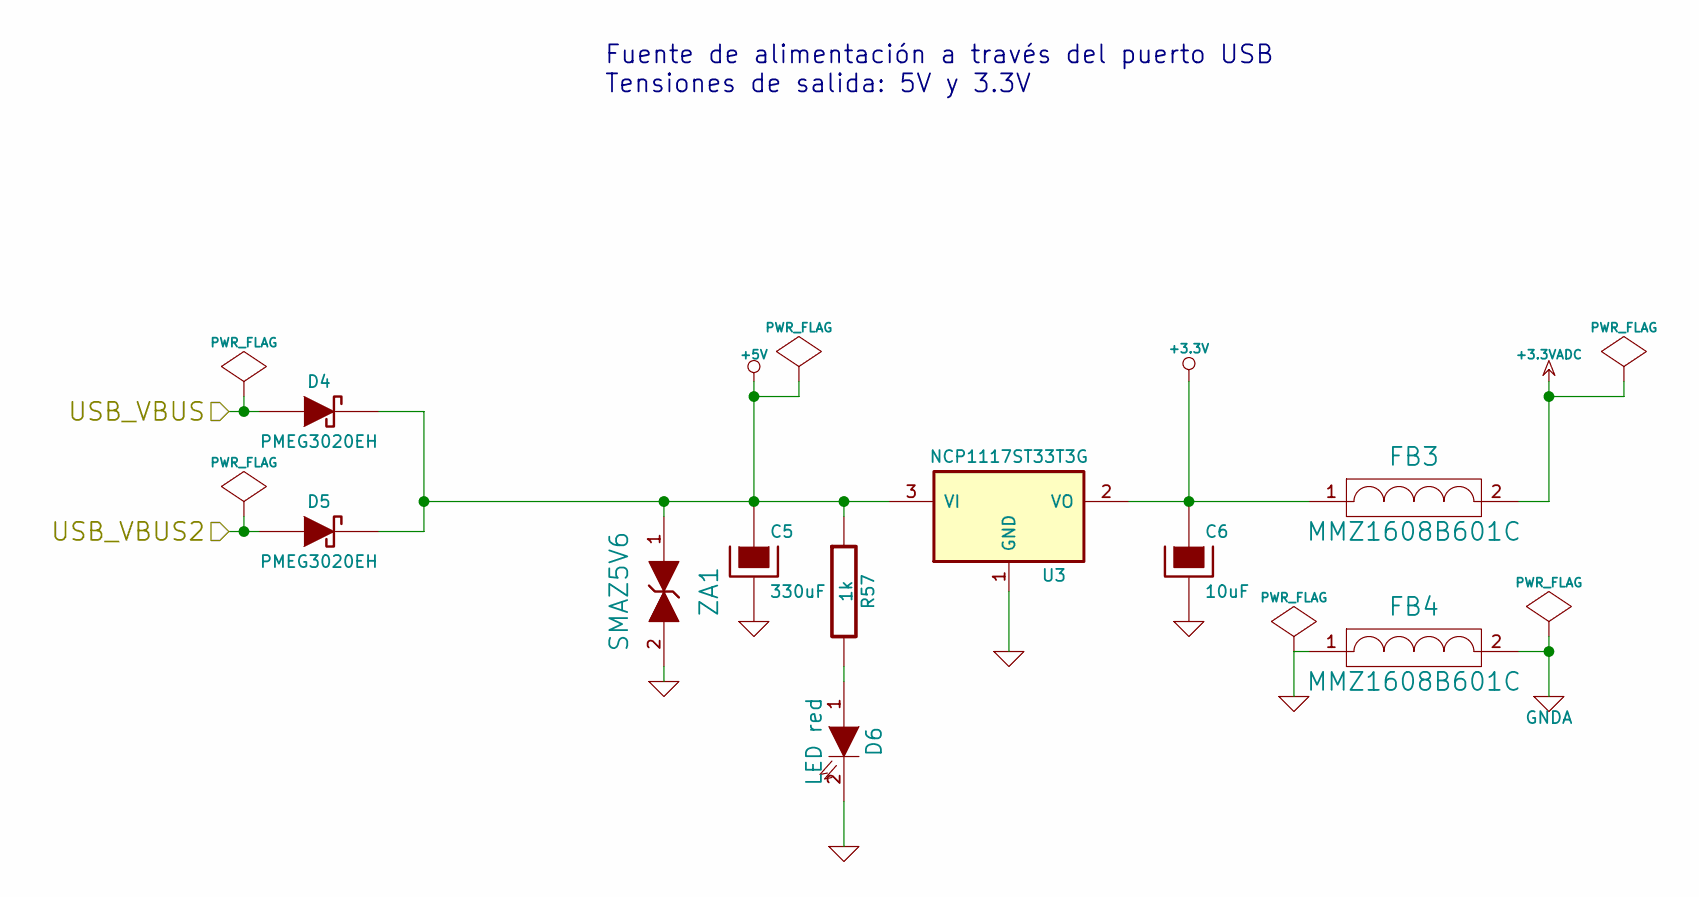
[picture p11: schematic fuente.sch, EDU CIAA Fuente de alimentación]

Parts:
C5: 330uF
C6: 10uF
D4, D5: PMEG3020EH
D6: LED red
FB3, FB4: MMZ1608B601C
R57: 1k
U3: NCP1117ST33T3G
ZA1: SMAZ5V6

Connections:
+3.3VADC: FB3.2; also elsewhere on the board
+5V: C5.1, D4.2 (K), D5.2 (K), R57.1, U3.3 (VI), ZA1.1; also elsewhere on the board
/CPU/USB_DEBUG_VBUS: D5.1 (A); also elsewhere on the board
/CPU/USB_VBUS: D4.1 (A); also elsewhere on the board
GND: C5.2, C6.2, D6.2 (K), FB4.1, U3.1 (GND), ZA1.2; also elsewhere on the board
GNDA: FB4.2; also elsewhere on the board
unnamed: D6.1 (A), R57.2

Notes on the sheet:
Fuente de alimentación a través del puerto USB Tensiones de salida: 5V y 3.3V

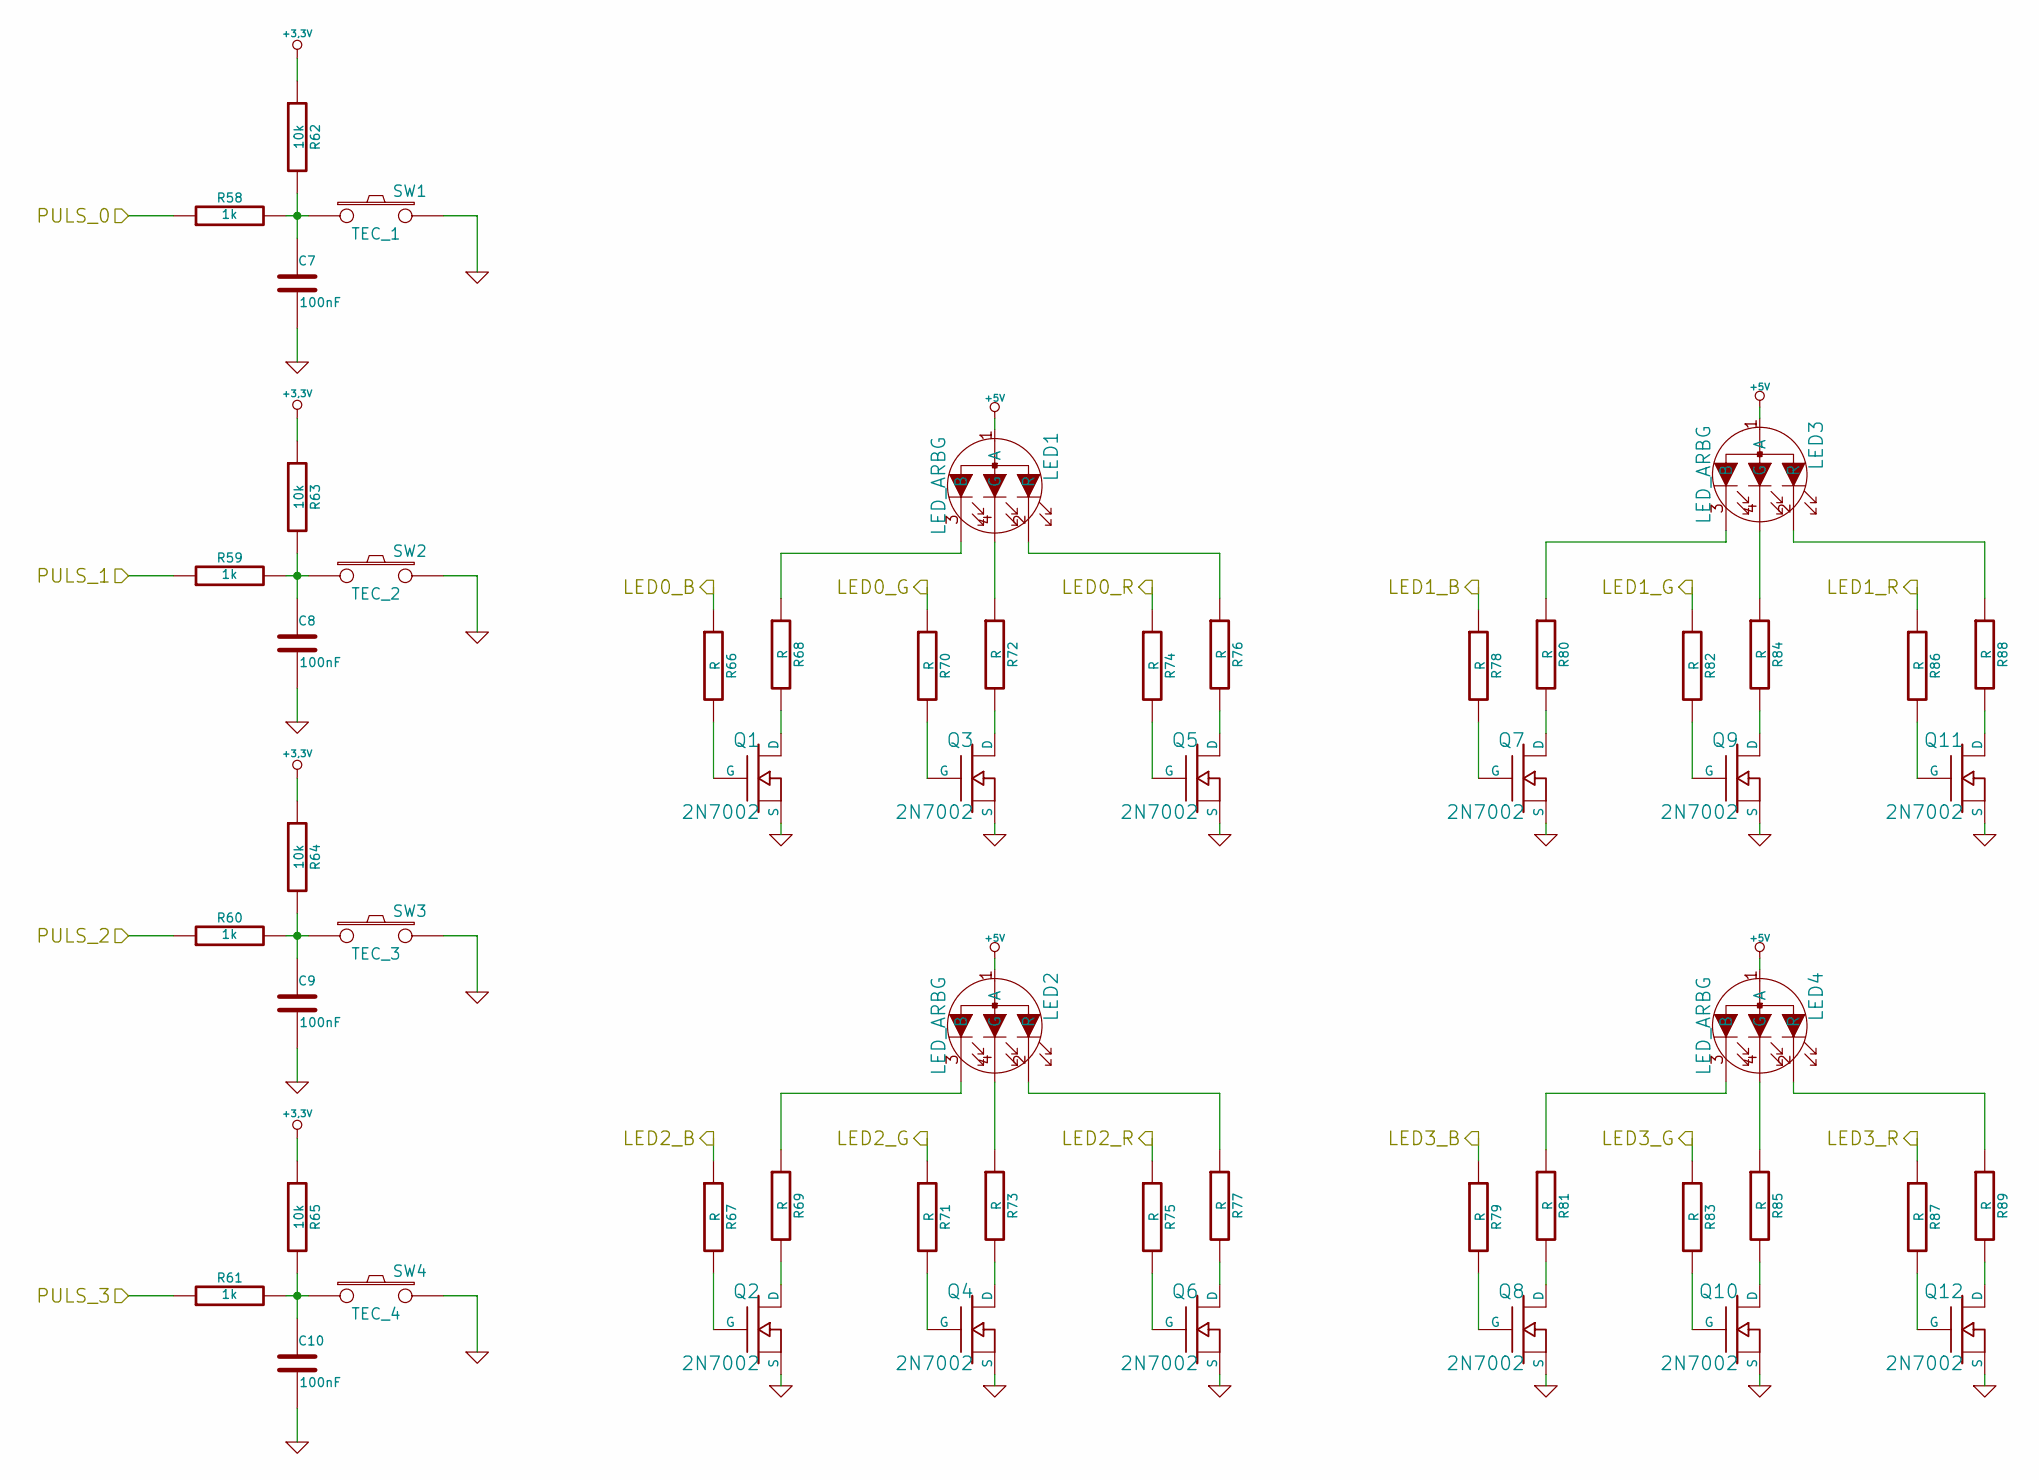
[picture p12: schematic ON_BOARD_IO.sch, EDU CIAA EXPANSIÓN]

Parts:
C7, C8, C9, C10: 100nF
LED1, LED2, LED3, LED4: LED_ARBG
Q1, Q2, Q3, Q4, Q5, Q6, Q7, Q8, Q9, Q10, Q11, Q12: 2N7002
R58, R59, R60, R61: 1k
R62, R63, R64, R65: 10k
R66, R67, R68, R69, R70, R71, R72, R73, R74, R75, R76, R77, R78, R79, R80, R81, R82, R83, R84, R85, R86, R87, R88, R89: R
SW1: TEC_1
SW2: TEC_2
SW3: TEC_3
SW4: TEC_4

Connections:
+5V: LED1.1 (A), LED2.1 (A), LED3.1 (A), LED4.1 (A); also elsewhere on the board
/CPU/LED0_B: R66.1; also elsewhere on the board
/CPU/LED0_G: R70.1; also elsewhere on the board
/CPU/LED0_R: R74.1; also elsewhere on the board
/CPU/LED1_B: R78.1; also elsewhere on the board
/CPU/LED1_G: R82.1; also elsewhere on the board
/CPU/LED1_R: R86.1; also elsewhere on the board
/CPU/LED2_B: R67.1; also elsewhere on the board
/CPU/LED2_G: R71.1; also elsewhere on the board
/CPU/LED2_R: R75.1; also elsewhere on the board
/CPU/LED3_B: R79.1; also elsewhere on the board
/CPU/LED3_G: R83.1; also elsewhere on the board
/CPU/LED3_R: R87.1; also elsewhere on the board
/CPU/PULS_0: R58.1; also elsewhere on the board
/CPU/PULS_1: R59.1; also elsewhere on the board
/CPU/PULS_2: R60.1; also elsewhere on the board
/CPU/PULS_3: R61.1; also elsewhere on the board
GND: C7.2, C8.2, C9.2, C10.2, Q1.S, Q2.S, Q3.S, Q4.S, Q5.S, Q6.S, Q7.S, Q8.S, Q9.S, Q10.S, Q11.S, Q12.S, SW1.2, SW2.2, SW3.2, SW4.2; also elsewhere on the board
unnamed: Q7.G, R78.2
unnamed: LED3.3 (B), R80.1
unnamed: Q7.D, R80.2
unnamed: C10.1, R61.2, R65.2, SW4.1
unnamed: Q5.G, R74.2
unnamed: Q2.G, R67.2
unnamed: Q2.D, R69.2
unnamed: Q9.D, R84.2
unnamed: Q9.G, R82.2
unnamed: LED3.4 (G), R84.1
unnamed: Q11.D, R88.2
unnamed: Q11.G, R86.2
unnamed: Q5.D, R76.2
unnamed: C7.1, R58.2, R62.2, SW1.1
unnamed: C9.1, R60.2, R64.2, SW3.1
unnamed: C8.1, R59.2, R63.2, SW2.1
unnamed: LED1.3 (B), R68.1
unnamed: Q1.D, R68.2
unnamed: Q1.G, R66.2
unnamed: Q12.G, R87.2
unnamed: Q12.D, R89.2
unnamed: LED1.4 (G), R72.1
unnamed: Q3.G, R70.2
unnamed: Q3.D, R72.2
unnamed: LED4.3 (B), R81.1
unnamed: Q8.D, R81.2
unnamed: Q8.G, R79.2
unnamed: Q10.G, R83.2
unnamed: LED4.4 (G), R85.1
unnamed: Q10.D, R85.2
unnamed: Q6.D, R77.2
unnamed: Q6.G, R75.2
unnamed: LED1.2 (R), R76.1
unnamed: LED2.4 (G), R73.1
unnamed: Q4.G, R71.2
unnamed: Q4.D, R73.2
unnamed: LED2.3 (B), R69.1
unnamed: LED2.2 (R), R77.1
unnamed: LED4.2 (R), R89.1
unnamed: LED3.2 (R), R88.1
