mpresso/Hardware/PCB/EDU-NXP/edu-ciaa-nxp.kicad_pcb

## KiCad design PCB/EDU-NXP/edu-ciaa-nxp.kicad_pcb (continued)

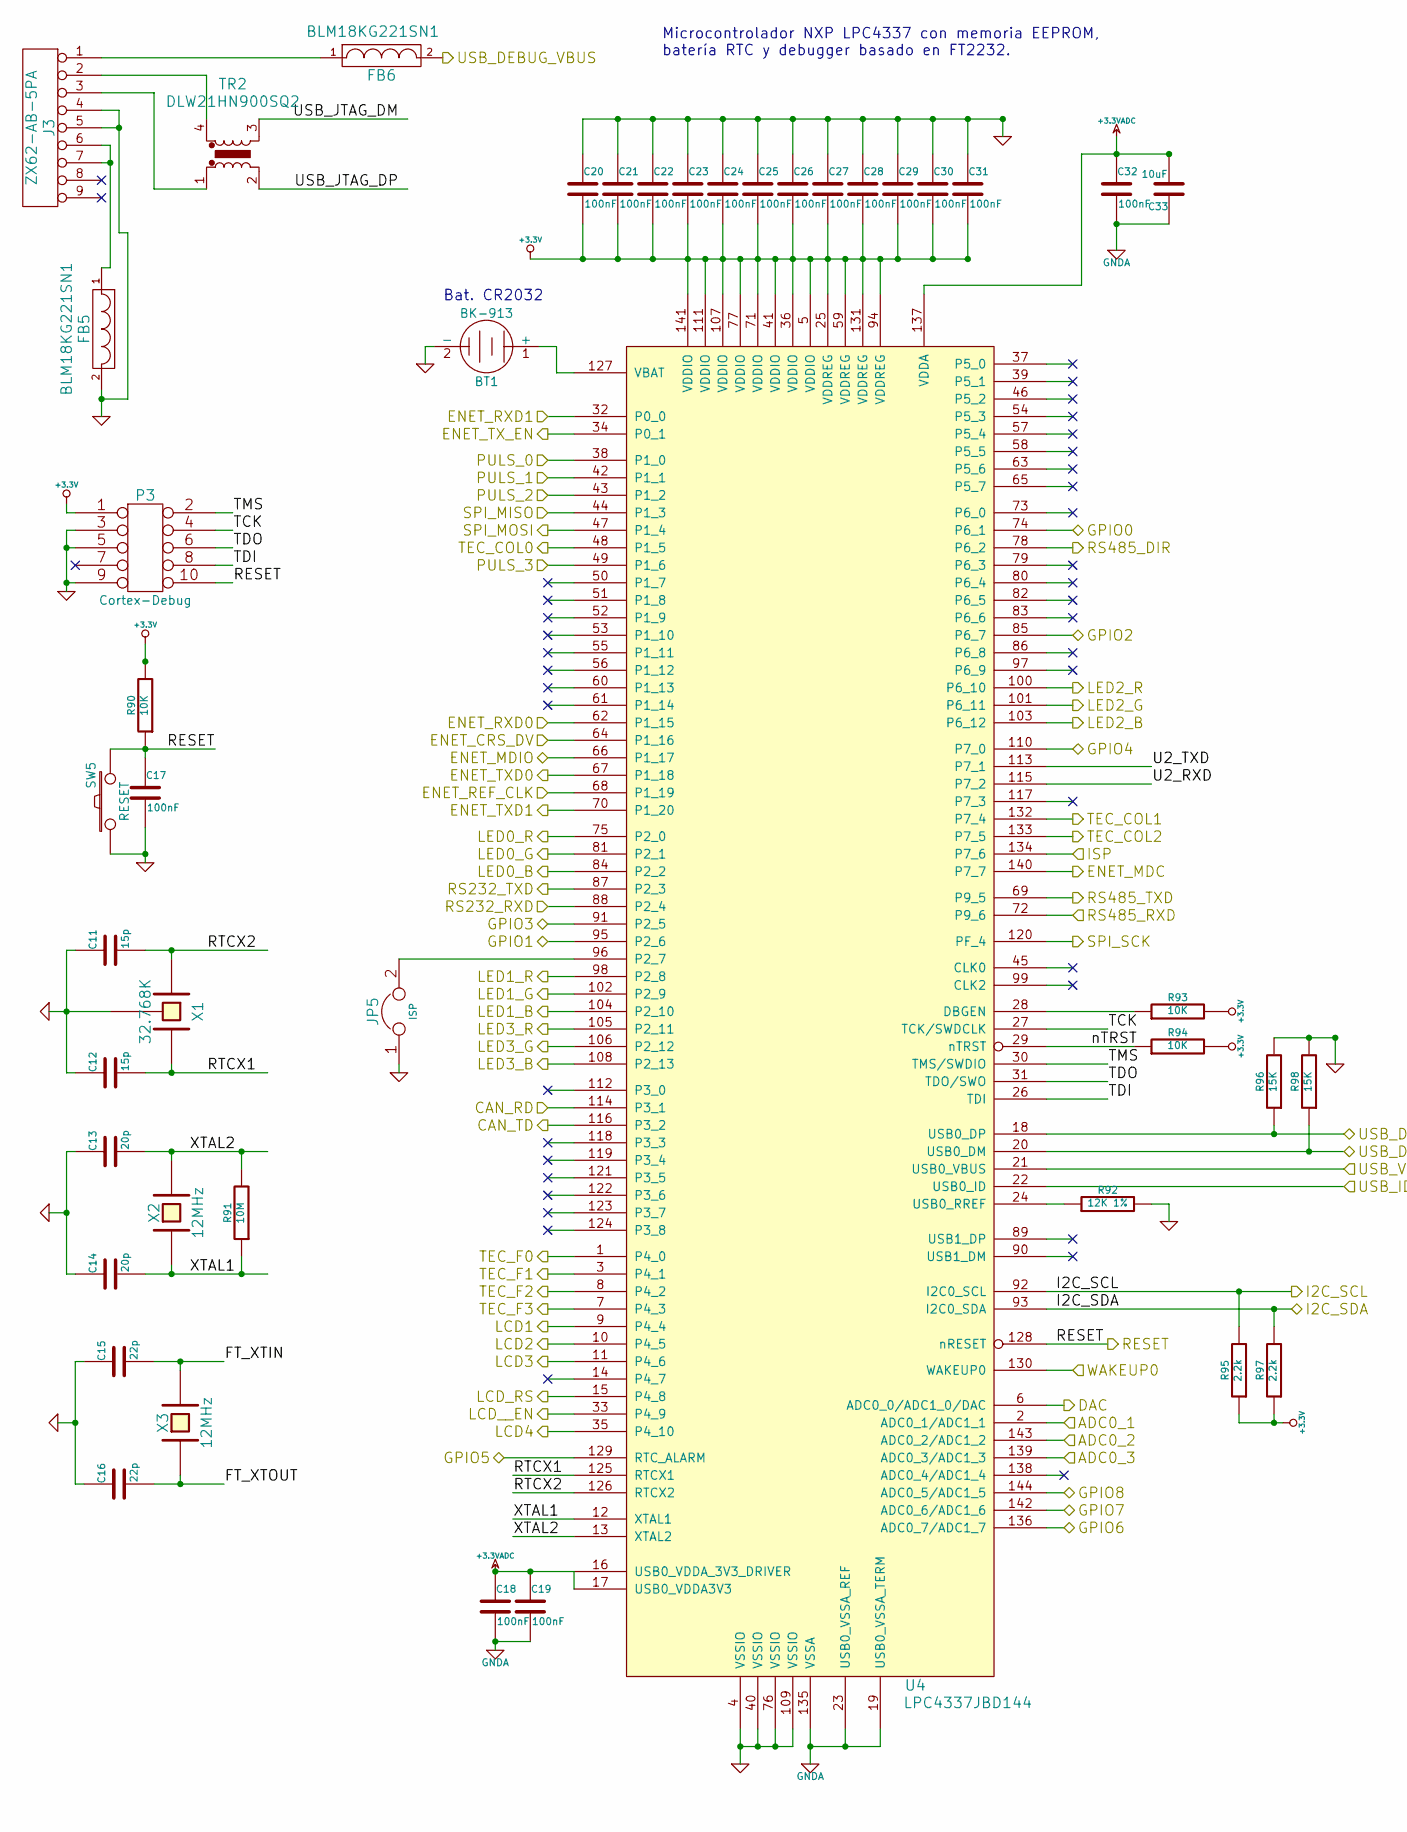
[picture p13: schematic cpu.sch, EDU CIAA CPU - LPC4337, part in row 1, column 1]

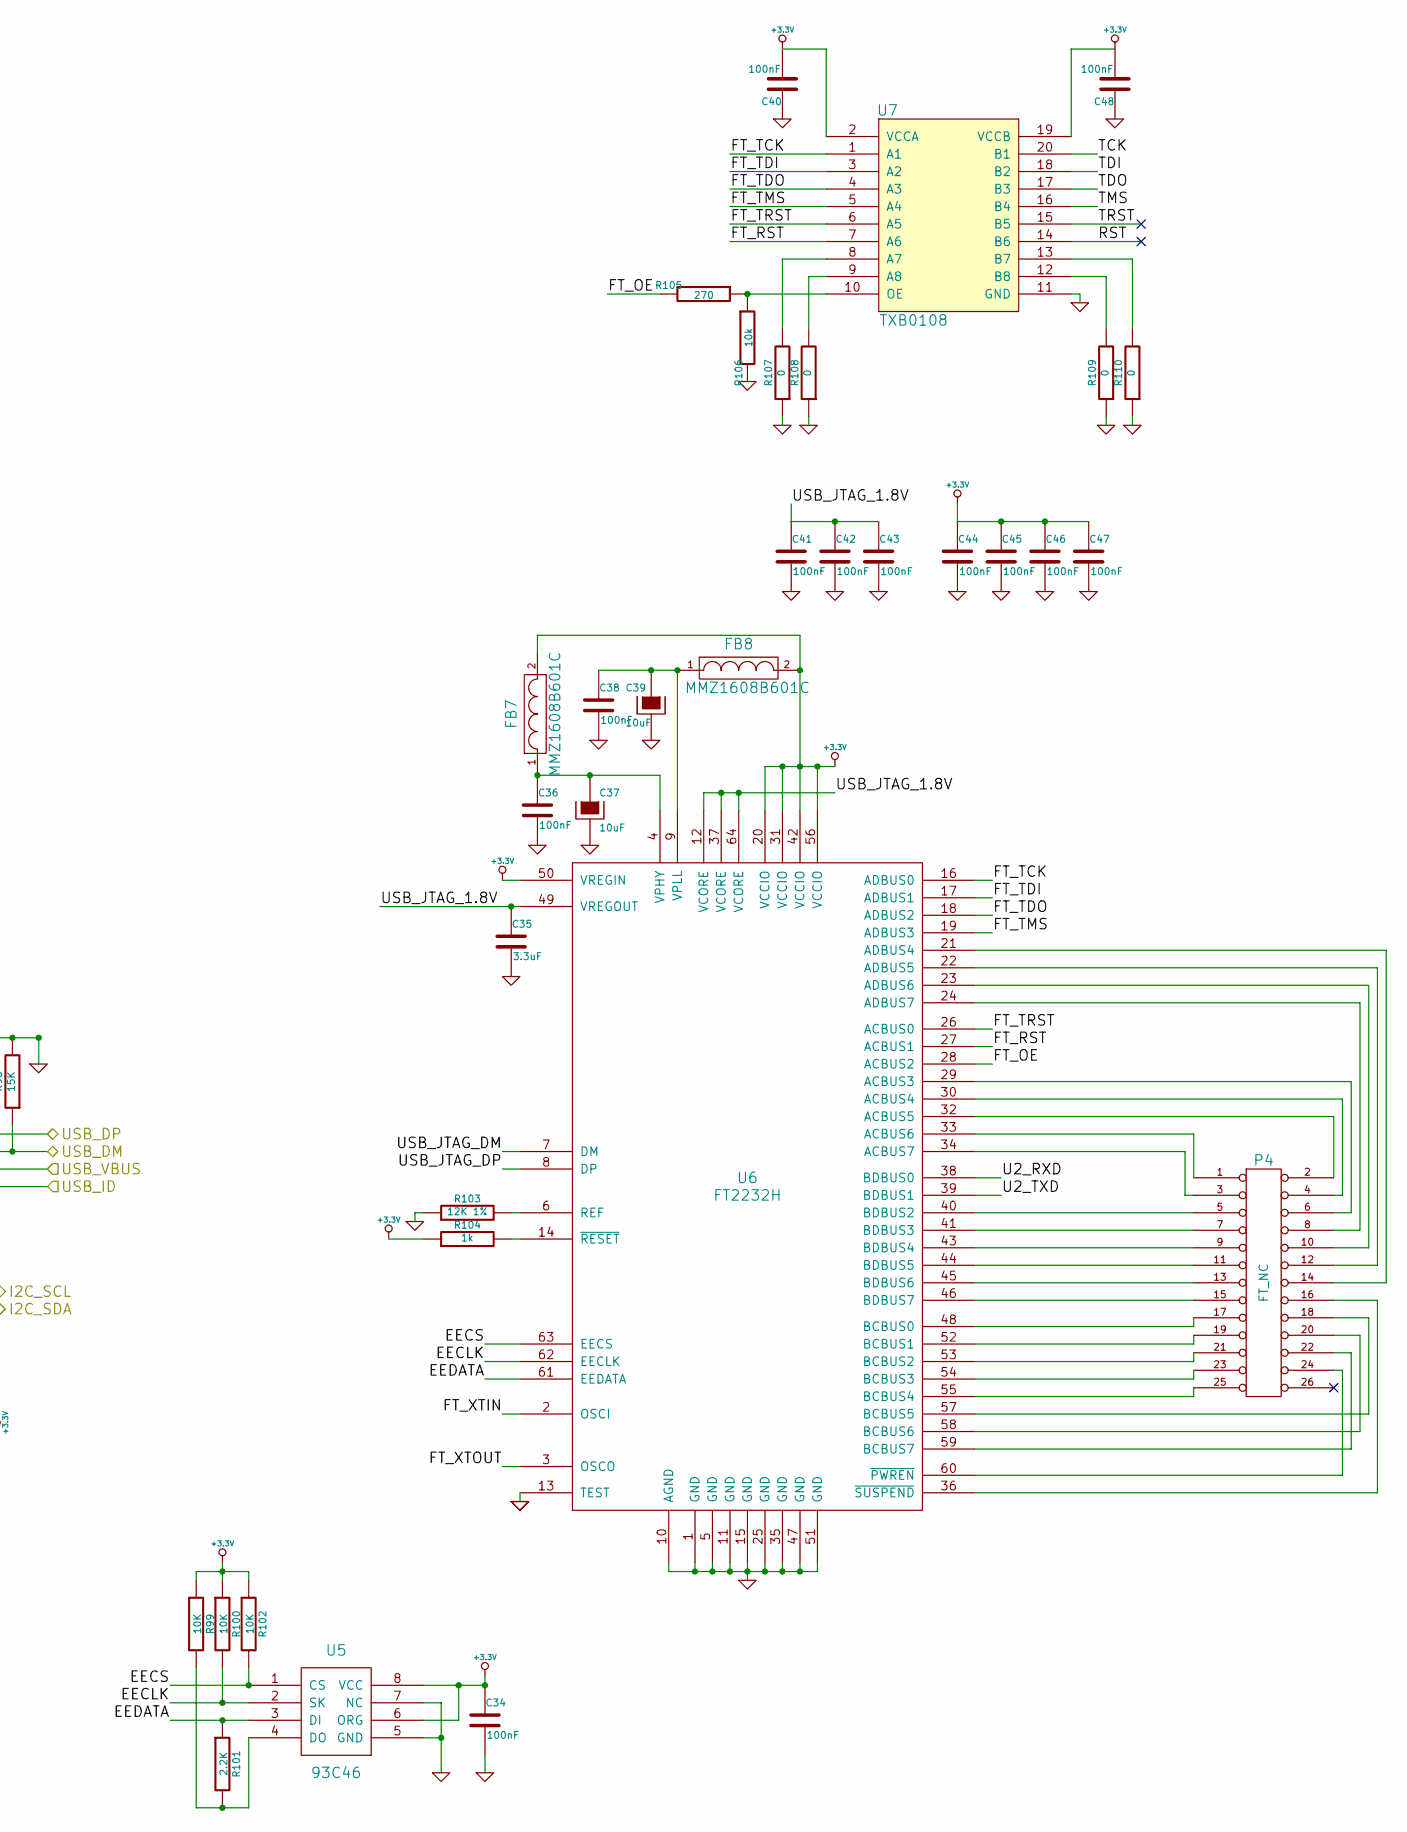
[picture p14: schematic cpu.sch, EDU CIAA CPU - LPC4337, part in row 1, column 2]

Parts:
BT1: BK-913
C11, C12: 15p
C13, C14: 20p
C15, C16: 22p
C17, C18, C19, C20, C21, C22, C23, C24, C25, C26, C27, C28, C29, C30, C31, C32, C34, C36, C38, C40, C41, C42, C43, C44, C45, C46, C47, C48: 100nF
C33, C37, C39: 10uF
C35: 3.3uF
FB5, FB6: BLM18KG221SN1
FB7, FB8: MMZ1608B601C
J3: ZX62-AB-5PA
JP5: ISP
P3: Cortex-Debug
P4: FT_NC
R90, R93, R94, R99, R100, R102: 10K
R91: 10M
R92, R103: 12K 1%
R95, R97: 2.2k
R96, R98: 15K
R101: 2.2K
R104: 1k
R105: 270
R106: 10k
R107, R108, R109, R110: 0
SW5: RESET
TR2: DLW21HN900SQ2
U4: LPC4337JBD144
U5: 93C46
U6: FT2232H
U7: TXB0108
X1: 32.768K
X2, X3: 12MHz

Connections:
+3.3VADC: C18.1, C19.1, C32.1, C33.2, U4.16 (USB0_VDDA_3V3_DRIVER), U4.17 (USB0_VDDA3V3), U4.137 (VDDA); also elsewhere on the board
/CPU/ADC0_1: U4.2 (ADC0_1/ADC1_1); also elsewhere on the board
/CPU/ADC0_2: U4.143 (ADC0_2/ADC1_2); also elsewhere on the board
/CPU/ADC0_3: U4.139 (ADC0_3/ADC1_3); also elsewhere on the board
/CPU/CAN_RD: U4.114 (P3_1); also elsewhere on the board
/CPU/CAN_TD: U4.116 (P3_2); also elsewhere on the board
/CPU/DAC: U4.6 (ADC0_0/ADC1_0/DAC); also elsewhere on the board
/CPU/EECLK: R100.2, U5.2 (SK), U6.62 (EECLK)
/CPU/EECS: R102.2, U5.1 (CS), U6.63 (EECS)
/CPU/EEDATA: R101.1, U5.3 (DI), U6.61 (EEDATA)
/CPU/ENET_CRS_DV: U4.64 (P1_16); also elsewhere on the board
/CPU/ENET_MDC: U4.140 (P7_7); also elsewhere on the board
/CPU/ENET_MDIO: U4.66 (P1_17); also elsewhere on the board
/CPU/ENET_REF_CLK: U4.68 (P1_19); also elsewhere on the board
/CPU/ENET_RXD0: U4.62 (P1_15); also elsewhere on the board
/CPU/ENET_RXD1: U4.32 (P0_0); also elsewhere on the board
/CPU/ENET_TXD0: U4.67 (P1_18); also elsewhere on the board
/CPU/ENET_TXD1: U4.70 (P1_20); also elsewhere on the board
/CPU/ENET_TX_EN: U4.34 (P0_1); also elsewhere on the board
/CPU/FT_OE: R105.2, U6.28 (ACBUS2)
/CPU/FT_RST: U6.27 (ACBUS1), U7.7 (A6)
/CPU/FT_TCK: U6.16 (ADBUS0), U7.1 (A1)
/CPU/FT_TDI: U6.17 (ADBUS1), U7.3 (A2)
/CPU/FT_TDO: U6.18 (ADBUS2), U7.4 (A3)
/CPU/FT_TMS: U6.19 (ADBUS3), U7.5 (A4)
/CPU/FT_TRST: U6.26 (ACBUS0), U7.6 (A5)
/CPU/FT_XTIN: C15.2, U6.2 (OSCI), X3.2
/CPU/FT_XTOUT: C16.2, U6.3 (OSCO), X3.1
/CPU/GPIO0: U4.74 (P6_1); also elsewhere on the board
/CPU/GPIO1: U4.95 (P2_6); also elsewhere on the board
/CPU/GPIO2: U4.85 (P6_7); also elsewhere on the board
/CPU/GPIO3: U4.91 (P2_5); also elsewhere on the board
/CPU/GPIO4: U4.110 (P7_0); also elsewhere on the board
/CPU/GPIO5: U4.129 (RTC_ALARM); also elsewhere on the board
/CPU/GPIO6: U4.136 (ADC0_7/ADC1_7); also elsewhere on the board
/CPU/GPIO7: U4.142 (ADC0_6/ADC1_6); also elsewhere on the board
/CPU/GPIO8: U4.144 (ADC0_5/ADC1_5); also elsewhere on the board
/CPU/I2C_SCL: R95.2, U4.92 (I2C0_SCL); also elsewhere on the board
/CPU/I2C_SDA: R97.2, U4.93 (I2C0_SDA); also elsewhere on the board
/CPU/ISP: U4.134 (P7_6); also elsewhere on the board
/CPU/LCD1: U4.9 (P4_4); also elsewhere on the board
/CPU/LCD2: U4.10 (P4_5); also elsewhere on the board
/CPU/LCD3: U4.11 (P4_6); also elsewhere on the board
/CPU/LCD4: U4.35 (P4_10); also elsewhere on the board
/CPU/LCD_RS: U4.15 (P4_8); also elsewhere on the board
/CPU/LED0_B: U4.84 (P2_2); also elsewhere on the board
/CPU/LED0_G: U4.81 (P2_1); also elsewhere on the board
/CPU/LED0_R: U4.75 (P2_0); also elsewhere on the board
/CPU/LED1_B: U4.104 (P2_10); also elsewhere on the board
/CPU/LED1_G: U4.102 (P2_9); also elsewhere on the board
/CPU/LED1_R: U4.98 (P2_8); also elsewhere on the board
/CPU/LED2_B: U4.103 (P6_12); also elsewhere on the board
/CPU/LED2_G: U4.101 (P6_11); also elsewhere on the board
/CPU/LED2_R: U4.100 (P6_10); also elsewhere on the board
/CPU/LED3_B: U4.108 (P2_13); also elsewhere on the board
/CPU/LED3_G: U4.106 (P2_12); also elsewhere on the board
/CPU/LED3_R: U4.105 (P2_11); also elsewhere on the board
/CPU/PULS_0: U4.38 (P1_0); also elsewhere on the board
/CPU/PULS_1: U4.42 (P1_1); also elsewhere on the board
/CPU/PULS_2: U4.43 (P1_2); also elsewhere on the board
/CPU/PULS_3: U4.49 (P1_6); also elsewhere on the board
/CPU/RESET: C17.1, P3.10, R90.1, SW5.2, U4.128 (nRESET); also elsewhere on the board
/CPU/RS232_RXD: U4.88 (P2_4); also elsewhere on the board
/CPU/RS232_TXD: U4.87 (P2_3); also elsewhere on the board
/CPU/RS485_DIR: U4.78 (P6_2); also elsewhere on the board
/CPU/RS485_RXD: U4.72 (P9_6); also elsewhere on the board
/CPU/RS485_TXD: U4.69 (P9_5); also elsewhere on the board
/CPU/RTCX1: C12.2, U4.125 (RTCX1), X1.2
/CPU/RTCX2: C11.2, U4.126 (RTCX2), X1.1
/CPU/SPI_MISO: U4.44 (P1_3); also elsewhere on the board
/CPU/SPI_MOSI: U4.47 (P1_4); also elsewhere on the board
/CPU/SPI_SCK: U4.120 (PF_4); also elsewhere on the board
/CPU/TCK: P3.4, U4.27 (TCK/SWDCLK), U7.20 (B1)
/CPU/TDI: P3.8, U4.26 (TDI), U7.18 (B2)
/CPU/TDO: P3.6, U4.31 (TDO/SWO), U7.17 (B3)
/CPU/TEC_COL0: U4.48 (P1_5); also elsewhere on the board
/CPU/TEC_COL1: U4.132 (P7_4); also elsewhere on the board
/CPU/TEC_COL2: U4.133 (P7_5); also elsewhere on the board
/CPU/TEC_F0: U4.1 (P4_0); also elsewhere on the board
/CPU/TEC_F1: U4.3 (P4_1); also elsewhere on the board
/CPU/TEC_F2: U4.8 (P4_2); also elsewhere on the board
/CPU/TEC_F3: U4.7 (P4_3); also elsewhere on the board
/CPU/TMS: P3.2, U4.30 (TMS/SWDIO), U7.16 (B4)
/CPU/U2_RXD: U4.115 (P7_2), U6.38 (BDBUS0)
/CPU/U2_TXD: U4.113 (P7_1), U6.39 (BDBUS1)
/CPU/USB_DEBUG_VBUS: FB6.2; also elsewhere on the board
/CPU/USB_DM: R98.1, U4.20 (USB0_DM); also elsewhere on the board
/CPU/USB_DP: R96.1, U4.18 (USB0_DP); also elsewhere on the board
/CPU/USB_ID: U4.22 (USB0_ID); also elsewhere on the board
/CPU/USB_JTAG_1.8V: C35.1, C41.1, C42.1, C43.1, U6.12 (VCORE), U6.37 (VCORE), U6.49 (VREGOUT), U6.64 (VCORE)
/CPU/USB_JTAG_DM: TR2.3, U6.7 (DM)
/CPU/USB_JTAG_DP: TR2.2, U6.8 (DP)
/CPU/USB_VBUS: U4.21 (USB0_VBUS); also elsewhere on the board
/CPU/XTAL1: C14.2, R91.1, U4.12 (XTAL1), X2.1
/CPU/XTAL2: C13.2, R91.2, U4.13 (XTAL2), X2.2
/CPU/nTRST: R94.1, U4.29 (nTRST)
/GPIO/LCD_EN: U4.33 (P4_9); also elsewhere on the board
/GPIO/WAKEUP: U4.130 (WAKEUP0); also elsewhere on the board
GND: BT1.2 (-), C11.1, C12.1, C13.1, C14.1, C15.1, C16.1, C17.2, C20.1, C21.1, C22.1, C23.1, C24.1, C25.1, C26.1, C27.1, C28.1, C29.1, C30.1, C31.1, C34.2, C35.2, C36.2, C37.2, C38.2, C39.2, C40.1, C41.2, C42.2, C43.2, C44.2, C45.2, C46.2, C47.2, C48.1, FB5.2, J3.4, J3.5, JP5.1, P3.3, P3.5, P3.9, R92.2, R96.2, R98.2, R103.1, R106.2, R107.1, R108.1, R109.1, R110.1, SW5.1, U4.4 (VSSIO), U4.40 (VSSIO), U4.76 (VSSIO), U4.109 (VSSIO), U5.5 (GND), U5.7 (NC), U6.1 (GND), U6.5 (GND), U6.10 (AGND), U6.11 (GND), U6.13 (TEST), U6.15 (GND), U6.25 (GND), U6.35 (GND), U6.47 (GND), U6.51 (GND), U7.11 (GND), X1.3 (GND); also elsewhere on the board
GNDA: C18.2, C19.2, C32.2, C33.1, U4.19 (USB0_VSSA_TERM), U4.23 (USB0_VSSA_REF), U4.135 (VSSA); also elsewhere on the board
unnamed: P4.2, U6.32 (ACBUS5)
unnamed: P4.1, U6.33 (ACBUS6)
unnamed: C36.1, C37.1, FB7.1, U6.4 (VPHY)
unnamed: R108.2, U7.9 (A8)
unnamed: R105.1, R106.1, U7.10 (OE)
unnamed: R110.2, U7.13 (B7)
unnamed: R109.2, U7.12 (B8)
unnamed: R107.2, U7.8 (A7)
unnamed: P4.25 (P24), U6.55 (BCBUS4)
unnamed: P4.11, U6.44 (BDBUS5)
unnamed: P4.21, U6.53 (BCBUS2)
unnamed: P4.12, U6.22 (ADBUS5)
unnamed: P4.13, U6.45 (BDBUS6)
unnamed: P4.23, U6.54 (BCBUS3)
unnamed: P4.14, U6.21 (ADBUS4)
unnamed: P4.24 (P20), U6.60 (~PWREN)
unnamed: P4.15, U6.46 (BDBUS7)
unnamed: P4.16, U6.36 (~SUSPEND)
unnamed: P4.17, U6.48 (BCBUS0)
unnamed: P4.18, U6.57 (BCBUS5)
unnamed: P4.19, U6.52 (BCBUS1)
unnamed: FB6.1, J3.1
unnamed: J3.3, TR2.1
unnamed: J3.2, TR2.4
unnamed: FB5.1, J3.6, J3.7
unnamed: P4.20, U6.58 (BCBUS6)
unnamed: P4.3, U6.34 (ACBUS7)
unnamed: P4.4, U6.30 (ACBUS4)
unnamed: P4.5, U6.40 (BDBUS2)
unnamed: P4.6, U6.29 (ACBUS3)
unnamed: P4.7, U6.41 (BDBUS3)
unnamed: P4.9, U6.43 (BDBUS4)
unnamed: P4.10, U6.23 (ADBUS6)
unnamed: R103.2, U6.6 (REF)
unnamed: R104.2, U6.14 (~RESET)
unnamed: R92.1, U4.24 (USB0_RREF)
unnamed: R99.2, R101.2, U5.4 (DO)
unnamed: JP5.2, U4.96 (P2_7)
unnamed: R93.1, U4.28 (DBGEN)
unnamed: BT1.1 (+), U4.127 (VBAT)
unnamed: C38.1, C39.1, FB8.1, U6.9 (VPLL)
unnamed: P4.8, U6.24 (ADBUS7)
unnamed: P4.22, U6.59 (BCBUS7)

Notes on the sheet:
Microcontrolador NXP LPC4337 con memoria EEPROM, batería RTC y debugger basado en FT2232.
Bat. CR2032

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
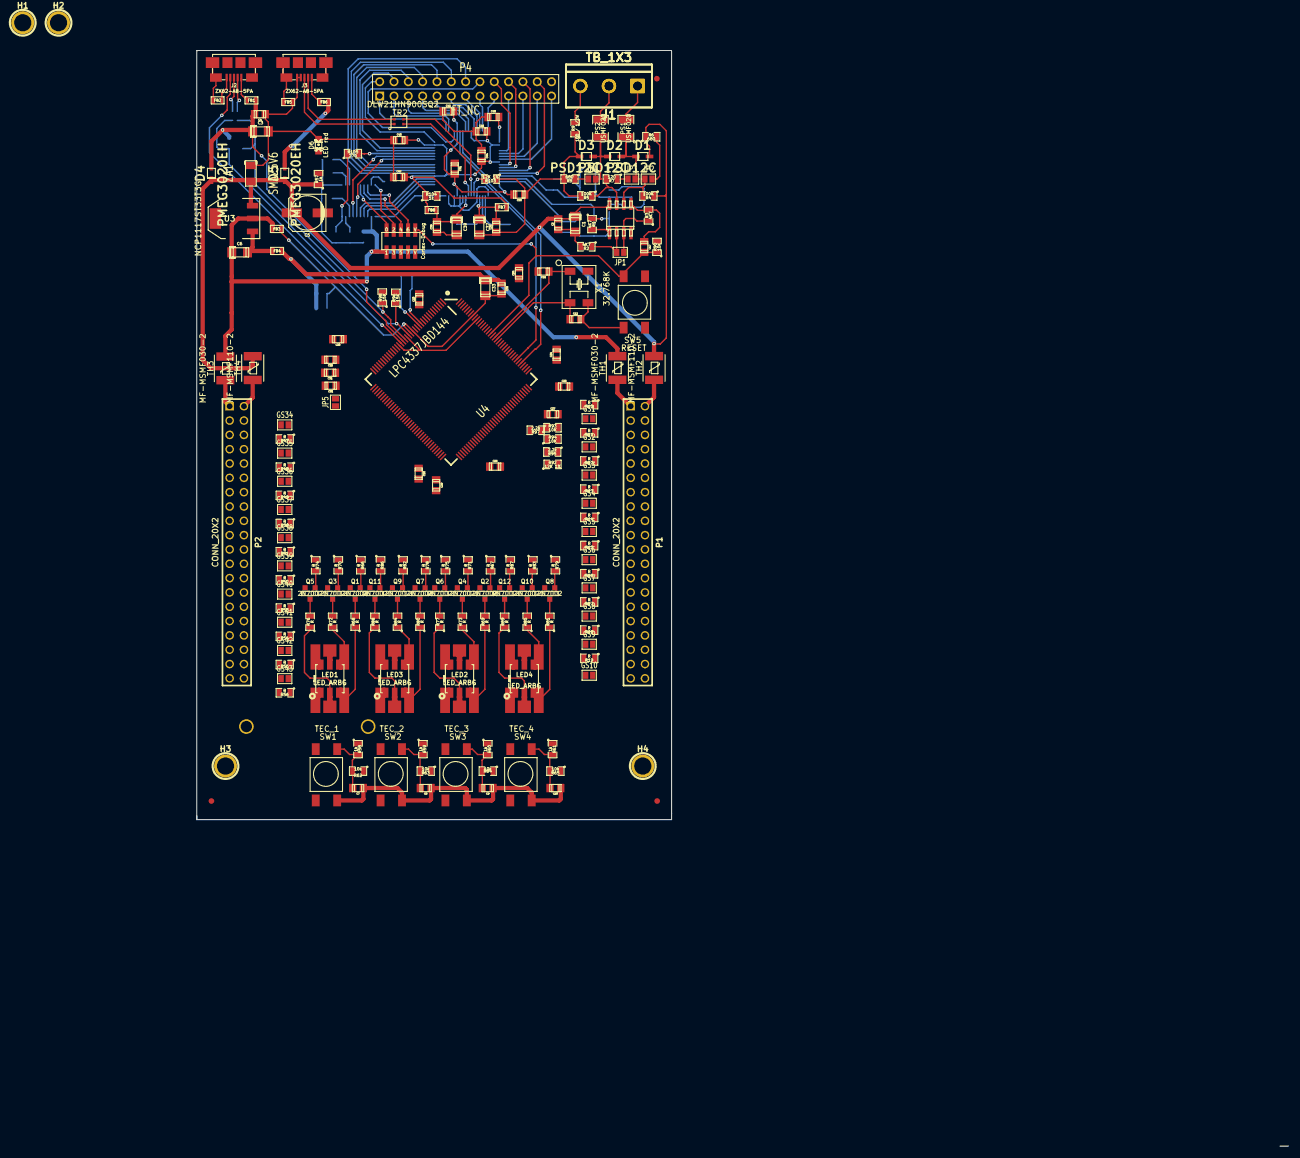
[picture p15: board edu-ciaa-nxp.kicad_pcb from above]

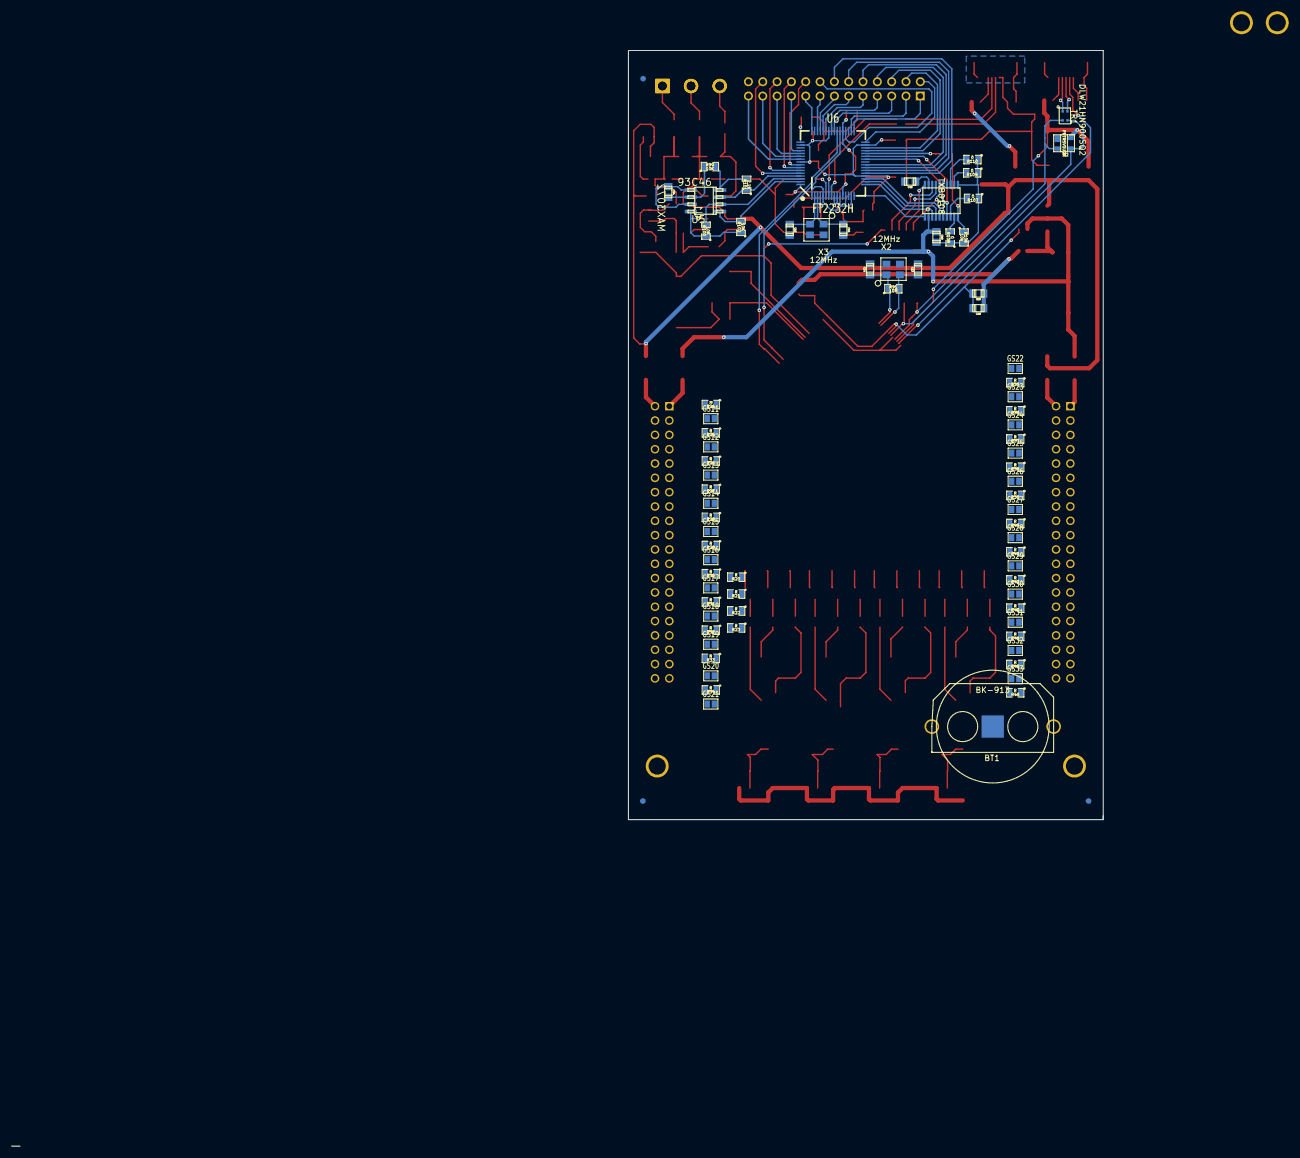
[picture p16: board edu-ciaa-nxp.kicad_pcb from below]

Board: 2 copper layers, 84.2 x 136.4 mm, 279 parts (77 on the bottom side), 250 nets.

Other parts of the board:
J1#2: TB_1X3; bornier3

Their connections:
unnamed 144: J1#2.2; also elsewhere on the board
unnamed 145: J1#2.3; also elsewhere on the board
unnamed 146: J1#2.1; also elsewhere on the board
