mpresso/Hardware/(commit log)

2014-06-10 Versión preliminar todavía con muchos errores de la EDU-CIAA-NXP
    [ON_BOARD_IO.sch, analog.sch, analog_out.sch, cpu.sch, din.sch, dout.sch, edu-ciaa-nxp.sch, ethernet.sch]
2014-06-10 Versión preliminar de la EDU-CIAA-NXP
2014-06-12 Versión con algunas mejoras
    [ON_BOARD_IO.sch, cpu.sch, edu-ciaa-nxp.sch, fuente.sch, gpio.sch, rsS485_rs232_can.sch, usb_otg.sch]
2014-06-13 LEDS RGB
    Se conectaron los LEDS RGB
    [CIAA_KIDS Pinouts (Rev 0.0).xlsx, Módulos de hardware a incluir en la CIAA para Universidades, Terciarios y Secundarios.xlsx]
2014-06-14 Primera versión
    Primera versión de la EDU - CIAA
    [CIAA_KIDS Pinouts (Rev 0.0).xlsx, ON_BOARD_IO.sch, analog.sch, analog_out.sch, cpu.sch, din.sch, dout.sch, edu-ciaa-nxp.sch]
2014-07-02 Borrador del PCB
    Borrador del PCB
2014-07-04 Borrador del PCB
    [CIAA_KIDS_Pinouts_Rev_0.0.xlsx, Modulos_hardwar_a_incluir.xlsx, ON_BOARD_IO.sch, cpu.sch, edu-ciaa-nxp.kicad_pcb, edu-ciaa-nxp.sch, fuente.sch, gpio.sch]
